elkhayder/PFE-DUT-2022-SmartCane/rapport/titlepage.tex

\makeatletter
\begin{titlepage}
\begin{center}
    
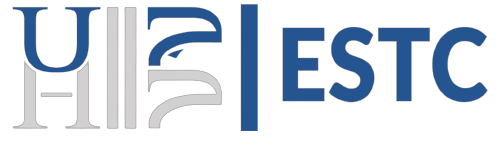
[picture p1: rapport/assets/estc.png]


\textbf{\large{
    Université HASSAN II de Casablanca \\
    École Supérieure de technologie \\
    Département Génie Électrique
}}
\\[4cm]

\textbf{\large{Rapport de projet de fin d'études}} \\[14pt]
Filière: Génie Électrique \\
Option: Électronique et informatique industrielle
\\[2cm]

\Small{Intitulé} \\
\textbf{\large{
Réalisation d'une canne intelligente avec sa propre\\
application mobile pour la navigation des malvoyants
}}

\vfill

\textbf{Realisé par :}
\hfill
\textbf{Encadré par :} \\
EL KHAYDER Zakaria
\hfill
Mme. DKHICHI Fairouz \\
\vspace{-4pt}
\begin{flushleft}
OUCHATO Iliass
\end{flushleft}
\\[1cm]

Année Universitaire \\
2021-2022
\\[24pt]

\end{center}
\end{titlepage}
\makeatother
