elkhayder/PFE-DUT-2022-SmartCane/rapport/code/app/send_current_location_sms.tex

\begin{code}
\begin{minted}[frame=single,
               framesep=3mm,
               linenos=true,
               xleftmargin=21pt,
               tabsize=4, fontsize=\small, breaklines]{dart}
class SendCurrentLocationSMS implements BluetoothPayloadHandler {
  final Telephony telephony = Telephony.instance;
  final LocationService location = LocationService();

  @override
  String command = "SEND_LOCATION_SMS";

  @override
  void handle(List<String> args) async {
    var currentLocation = await location.updateCurrentLocation();
    var prefs = await SharedPreferences.getInstance();
    String message = prefs.getString("emergencyMessage") ?? Constants.defaultEmergencyMessage;
    List<EmergencyContact> contacts = await Helpers.fetchEmergencyContacts();

    if (currentLocation?.longitude != null && currentLocation?.latitude != null) {
      message += "https://www.google.com/maps/search/?api=1&query=${currentLocation
      !.latitude!.toString()}%2C${currentLocation.longitude!.toString()}";
    }

    if (contacts.isEmpty) {
      await Helpers.speak(
        "You don't have any emergency contacts, please add at least one in the settings menu.",
      );
      return;
    }

    for (var c in contacts) {
      await telephony.sendSms(
        to: c.phone,
        message: message,
      );
    }

    await Helpers.speak(
      "Location SMS sent to ${contacts.length} ${contacts.length == 1 ? "person" : "people"}",
    );
  }
}
\end{minted}
\caption{Expéditeur d'SMS d'urgence}
\end{code}
