elkhayder/PFE-DUT-2022-SmartCane/rapport/code/arduino/Button.tex

\begin{code}
\begin{minted}[frame=single, framesep=3mm, linenos=true, xleftmargin=21pt, tabsize=4, fontsize=\small, breaklines]{cpp}

#include <Arduino.h>

#include "../../includes/ringtones.cpp"

class Button {
public:
    // All times are in ms
    unsigned long singlePressPolling = 1000;
    unsigned long doublePressTimeout = 250;
    unsigned long longPressTriggerTimeout = 1000;
    unsigned long minPressPolling = 10;

private:
    int _port;
    bool _prevState = false;
    bool _currentState = false;
    bool _singlePressInQueue = false;
    bool _longPressInProgress = false;
    unsigned long _lastPressedAt = 0;

    // Handlers
    void (*_onPress)();
    void (*_onDoublePress)();
    void (*_onLongPress)();

    static void _defaultHandler() {}

public:
    Button(
        int port,
        void (*onPress)(),
        void (*onDoublePress)() = _defaultHandler,
        void (*onLongPress)() = _defaultHandler
    ) {
        _port = port;
        _onPress = onPress;
        _onDoublePress = onDoublePress;
        _onLongPress = onLongPress;

        pinMode(port, INPUT_PULLUP);
    }

    void listen() {
        _currentState = !(bool)digitalRead(_port);

        if (millis() < _lastPressedAt + minPressPolling)
            return;

        if (_singlePressInQueue) {
            if (_currentState && _prevState) {
                if (millis() >= _lastPressedAt + longPressTriggerTimeout) {
                    handleLongPress();
                    _singlePressInQueue = false;
                    _longPressInProgress = false;
                    _lastPressedAt = millis();
                }
            } else if (millis() <= _lastPressedAt + doublePressTimeout && _currentState && !_prevState) {
                handleDoublePress();
                _singlePressInQueue = false;
                _lastPressedAt = millis();
            } else if (millis() > _lastPressedAt + doublePressTimeout) {
                handlePress();
                _singlePressInQueue = false;
                _lastPressedAt = millis();
            }
        } else if (millis() >= _lastPressedAt + singlePressPolling && _currentState && !_prevState) {
            _singlePressInQueue = true;
            _longPressInProgress = false;
            _lastPressedAt = millis();
        }

        _prevState = _currentState;
    }

private:
    void handlePress() {
        Ringtones::buttonClick.play();
        _onPress();
    }

    void handleDoublePress() {
        Ringtones::buttonDoubleClick.play();
        _onDoublePress();
    }

    void handleLongPress() {
        Ringtones::buttonLongClick.play();
        _onLongPress();
    }
};
\end{minted}
\caption{Button}
\end{code}
