elkhayder/PFE-DUT-2022-SmartCane/rapport/dedicace.tex

\chapter*{Dédicace}
\addcontentsline{toc}{chapter}{Dédicace}

Nous dédions ce modeste travail à : \\
\begin{itemize}
    \item En premier lieu ceux que personne ne peut compenser les sacrifices qu’ils ont consentis pour notre éducation et notre bien-être à nos parents qui se sont sacrifiés pour nous prendre en charge tout au long de notre formation et qui sont l’origine de notre réussite que dieu les garde et les protèges.
    \item A notre famille et nos chers amis qui nous ont accordé leur soutien dans les instants les plus difficiles.
    \item Tous nos formateurs et toute l’équipe pédagogique et administrative de \acrshort{estc} pour l’aide qu’ils ont toujours porté aux étudiants.
    \item Toute personne qui de près ou de loin a participé à notre formation.
\end{itemize}
