elkhayder/PFE-DUT-2022-SmartCane/rapport/remerciement.tex

\chapter*{Remerciement}
\addcontentsline{toc}{chapter}{Remerciement}

Au terme de ce travail, on tient à exprimer notre profonde gratitude à notre chère professeur et encadrante \textbf{Mme.\ DKHICHI Fairouz} pour son suivi et pour son énorme soutien %, qu’elle n’a cessé de nous prodiguer 
tout au long de la période du projet. \\
On tient à remercier également \textbf{M. LAROUI Abderrahim} et \textbf{M. BOUTAKAOUA BACHIR\\Mohamed} pour le temps qu’ils ont consacré et pour les précieuses informations lors de la conception et la réalisation de notre projet. \\
On adresse aussi nos vifs remerciements aux membres des jurys pour avoir bien voulu examiner et juger ce travail. \\
On ne laissera pas cette occasion passer, sans remercier tous les enseignants et le personnel de \textbf{\acrfull{estc}}, et particulièrement ceux du département électrique pour leur aide et leurs précieux conseils et pour l’intérêt qu’ils portent à notre formation. \\
Enfin, nos remerciements à tous ceux qui ont contribué de prés ou de loin au bon déroulement de ce projet de fin d'étude.
%Tous nos camarades de promotion pour la solidarité et la collaboration durant ces trois ans de formation.
