elkhayder/PFE-DUT-2022-SmartCane/rapport/assets/conception1/21.png

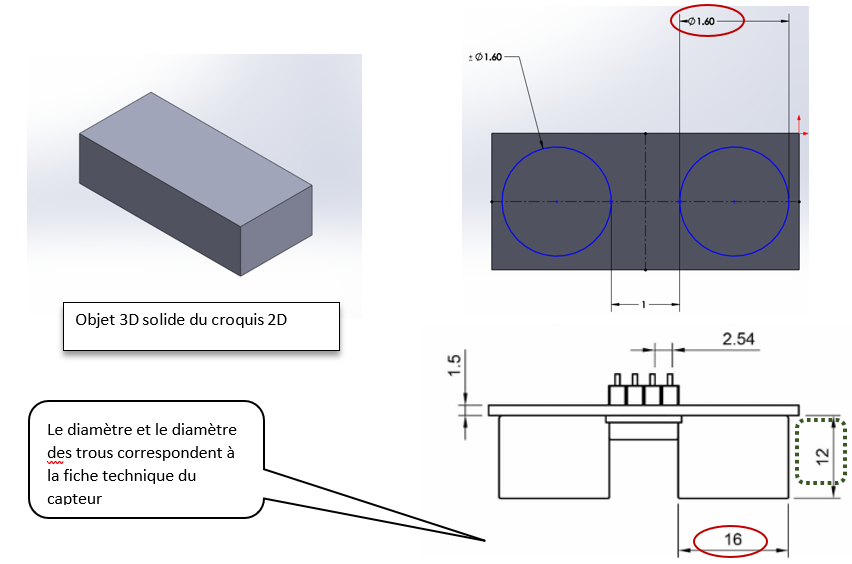
rapport/assets/conception1/21.png
