elkhayder/PFE-DUT-2022-SmartCane/rapport/assets/conception1/img38.jpg

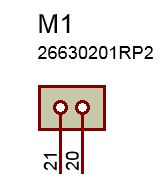
rapport/assets/conception1/img38.jpg
