elkhayder/PFE-DUT-2022-SmartCane/rapport/assets/conception1/img148.jpg

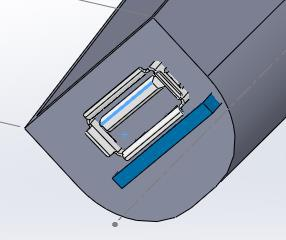
rapport/assets/conception1/img148.jpg
