elkhayder/PFE-DUT-2022-SmartCane/rapport/assets/conception1/img245.jpg

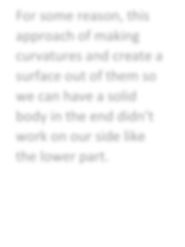
rapport/assets/conception1/img245.jpg
