elkhayder/PFE-DUT-2022-SmartCane/rapport/assets/conception1/img249.jpg

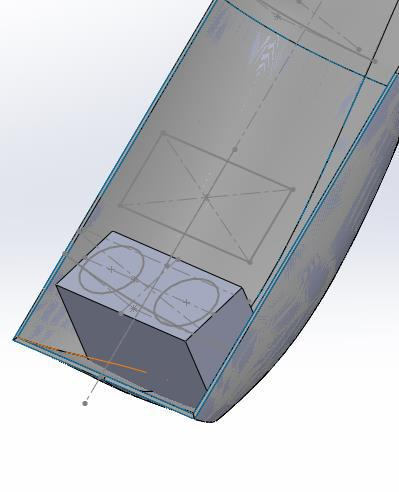
rapport/assets/conception1/img249.jpg
