elkhayder/PFE-DUT-2022-SmartCane/rapport/assets/conception1/img298.jpg

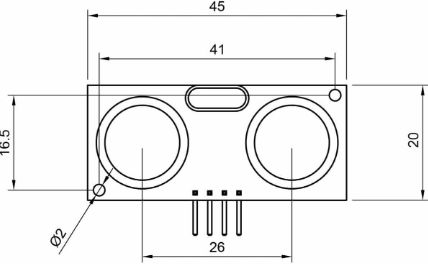
rapport/assets/conception1/img298.jpg
