elkhayder/PFE-DUT-2022-SmartCane/rapport/assets/conception1/injection-moulding-process-stage1-356x141.gif

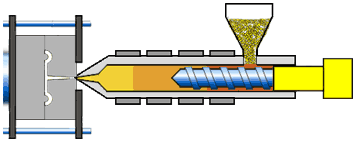
rapport/assets/conception1/injection-moulding-process-stage1-356x141.gif
