elkhayder/PFE-DUT-2022-SmartCane/rapport/assets/HC-05/circuit.png

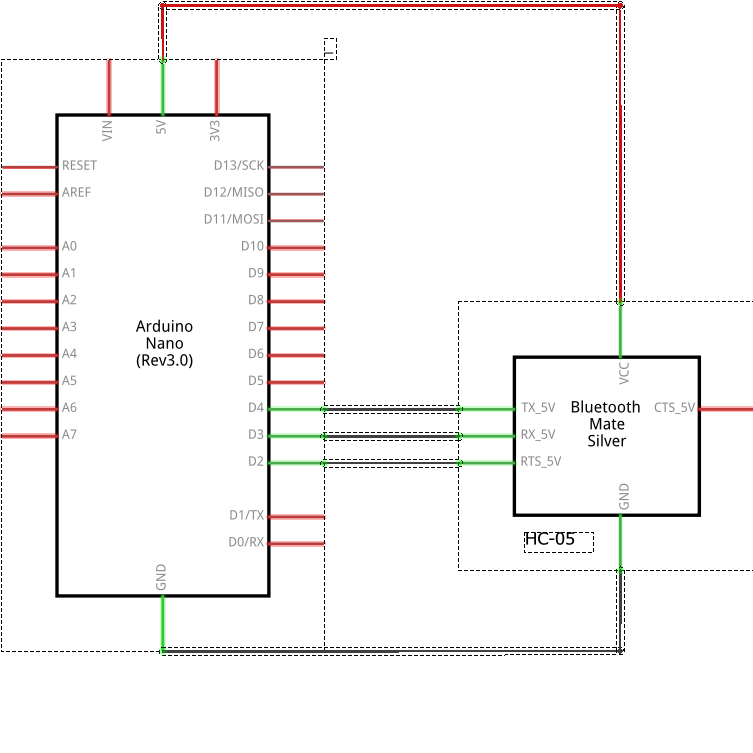
rapport/assets/HC-05/circuit.png
