elkhayder/PFE-DUT-2022-SmartCane/rapport/assets/HC-SR04/pinout.png

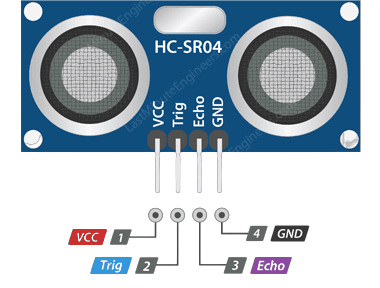
rapport/assets/HC-SR04/pinout.png
