elkhayder/PFE-DUT-2022-SmartCane/rapport/assets/L293D/pinout.png

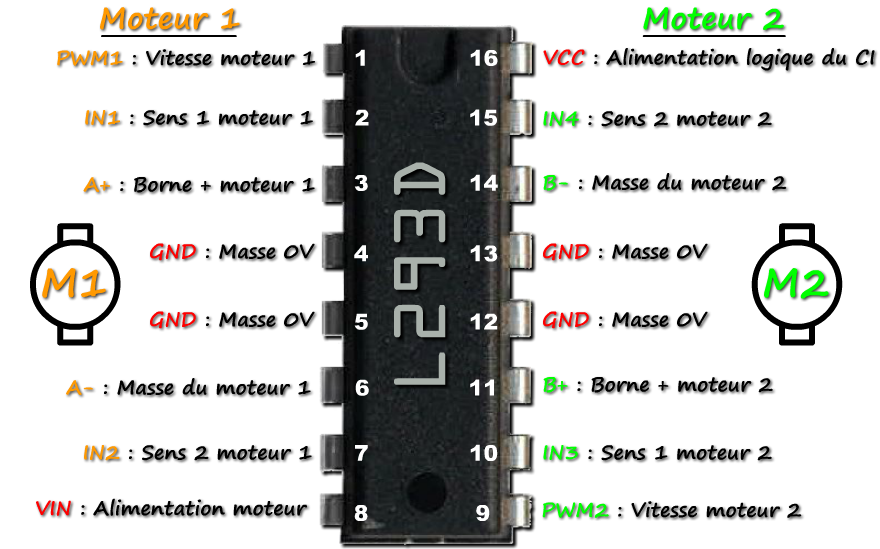
rapport/assets/L293D/pinout.png
