elkhayder/PFE-DUT-2022-SmartCane/rapport/assets/realisation/1.jpg

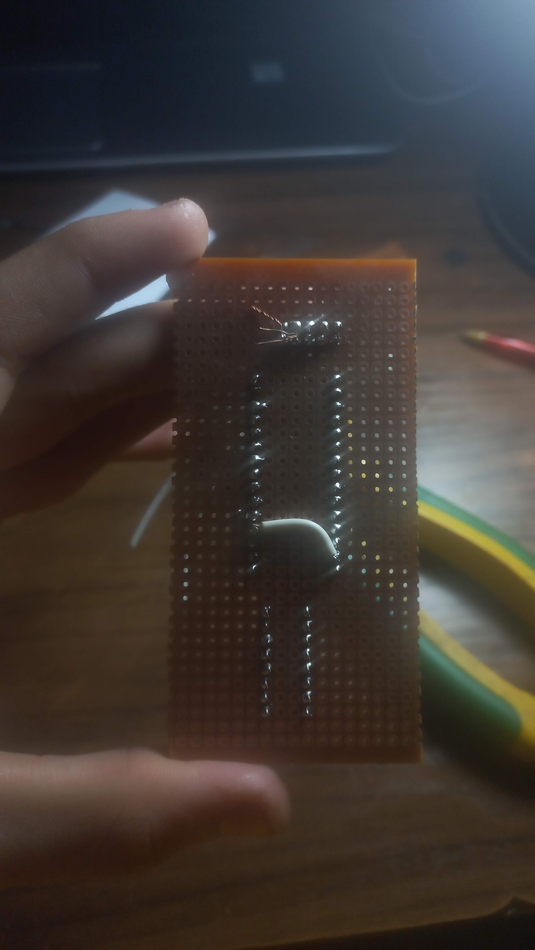
rapport/assets/realisation/1.jpg
