elkhayder/PFE-DUT-2022-SmartCane/rapport/assets/realisation/2.jpg

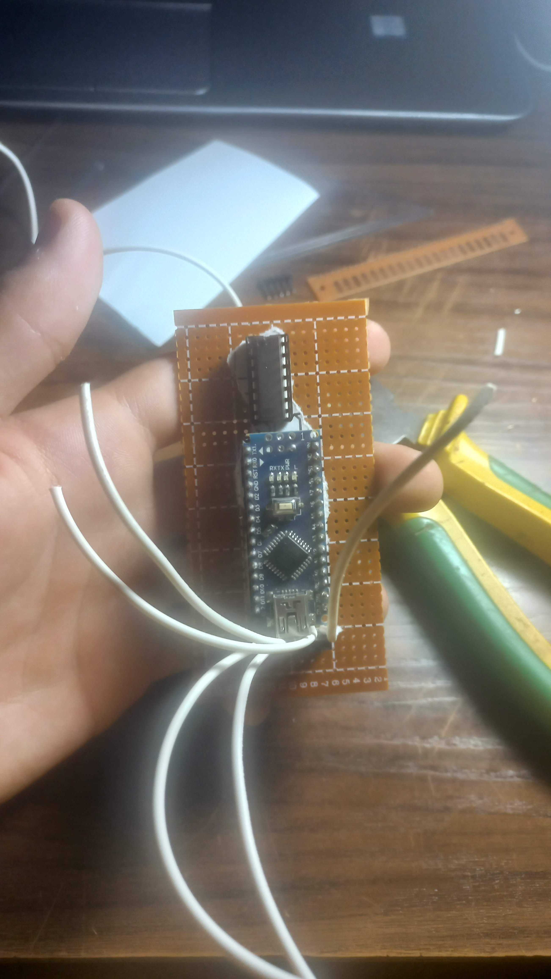
rapport/assets/realisation/2.jpg
