elkhayder/PFE-DUT-2022-SmartCane/rapport/assets/realisation/3.jpg

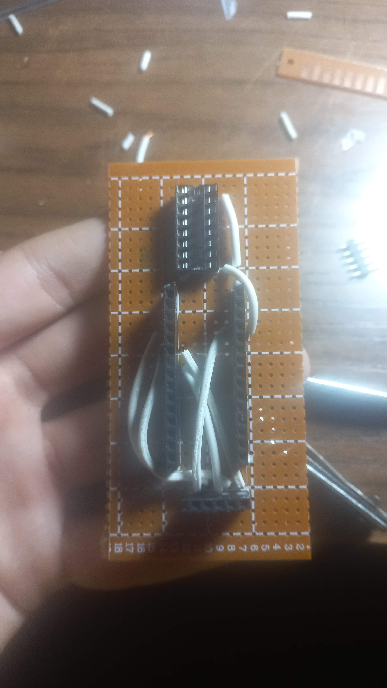
rapport/assets/realisation/3.jpg
