elkhayder/PFE-DUT-2022-SmartCane/rapport/assets/realisation/20220409_154331.jpg

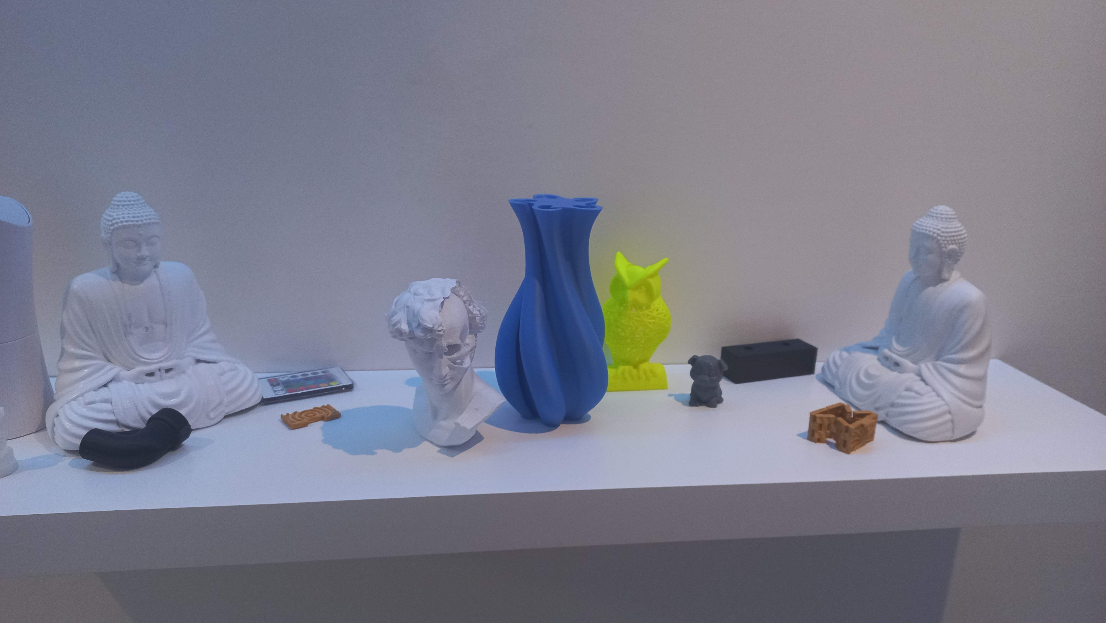
rapport/assets/realisation/20220409_154331.jpg
