elkhayder/PFE-DUT-2022-SmartCane/rapport/assets/realisation/20220409_162800.jpg

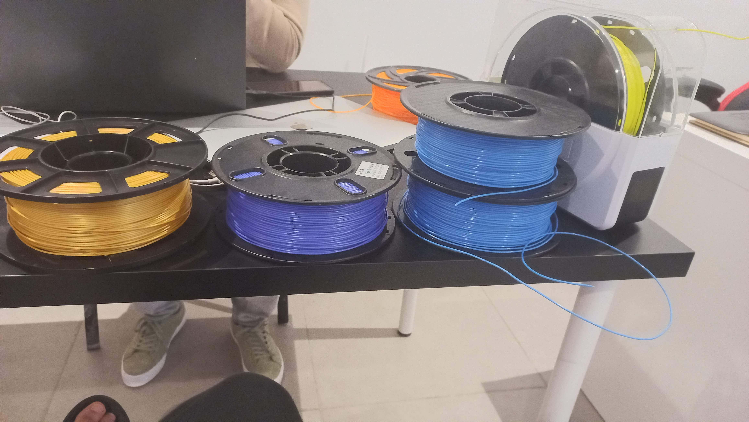
rapport/assets/realisation/20220409_162800.jpg
