elkhayder/PFE-DUT-2022-SmartCane/rapport/assets/realisation/cartes/2022-03-25 11.55.35.jpeg

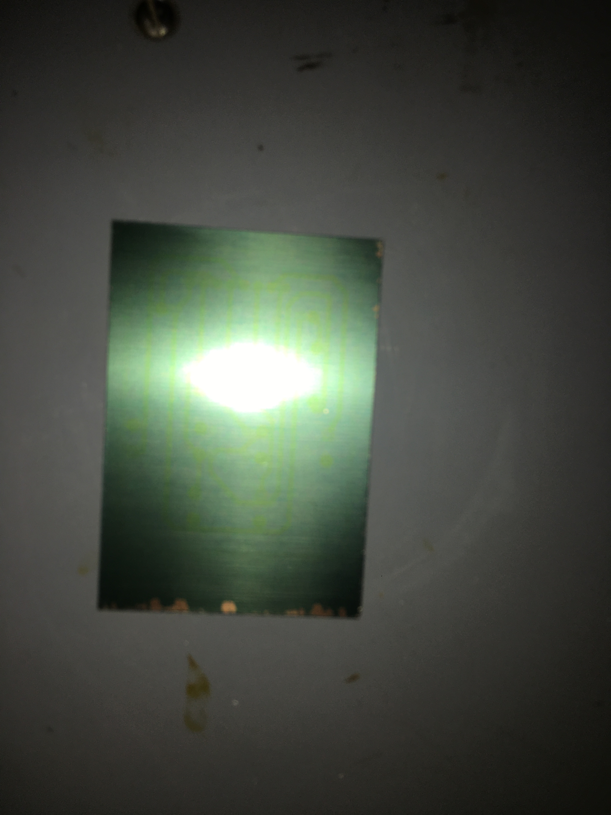
rapport/assets/realisation/cartes/2022-03-25 11.55.35.jpeg
