elkhayder/PFE-DUT-2022-SmartCane/rapport/assets/realisation/cartes/2022-03-25 12.16.34.jpeg

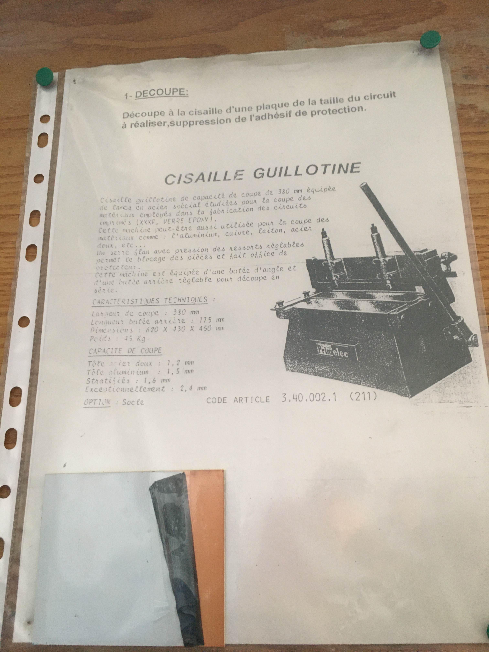
rapport/assets/realisation/cartes/2022-03-25 12.16.34.jpeg
