elkhayder/PFE-DUT-2022-SmartCane/rapport/assets/realisation/cartes/2022-03-25 16.49.51.jpeg

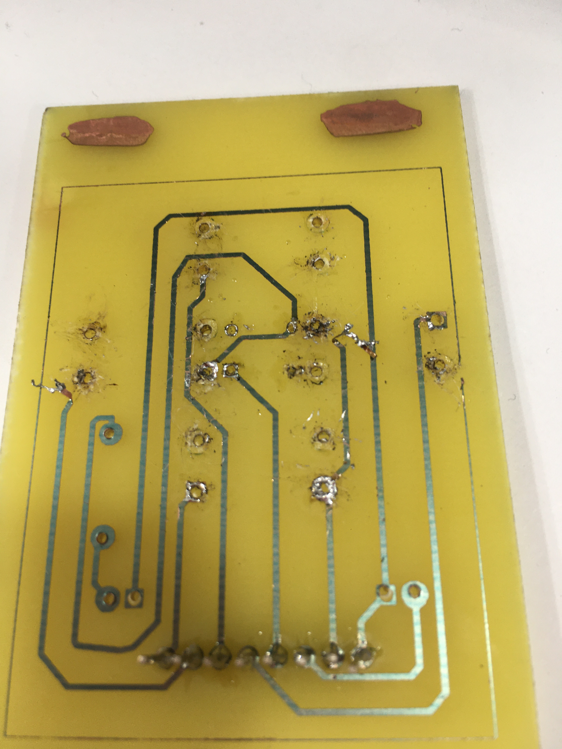
rapport/assets/realisation/cartes/2022-03-25 16.49.51.jpeg
