elkhayder/PFE-DUT-2022-SmartCane/rapport/assets/realisation/cartes/2022-03-25 18.37.08.jpeg

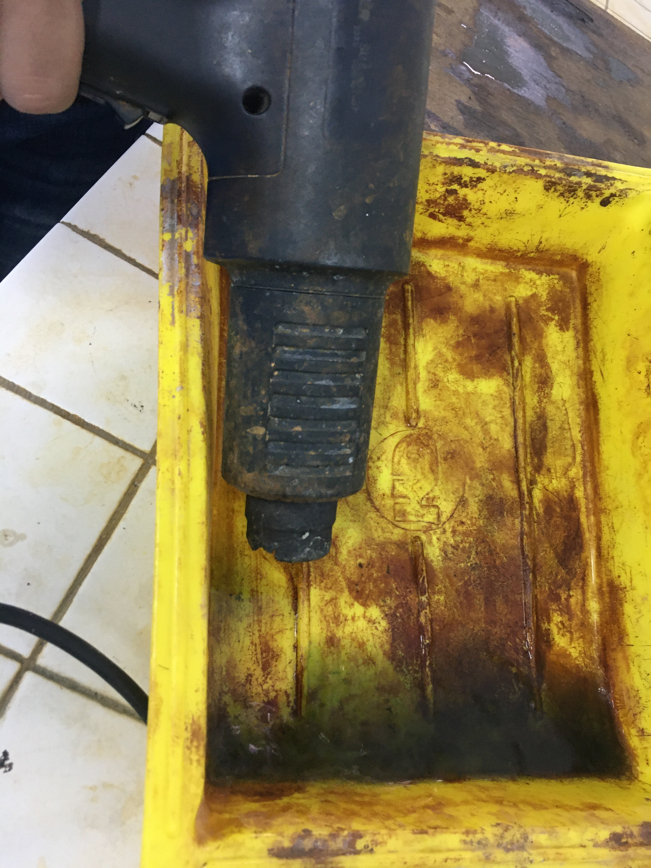
rapport/assets/realisation/cartes/2022-03-25 18.37.08.jpeg
