elkhayder/PFE-DUT-2022-SmartCane/rapport/assets/realisation/cartes/2022-03-28 17.06.08.jpeg

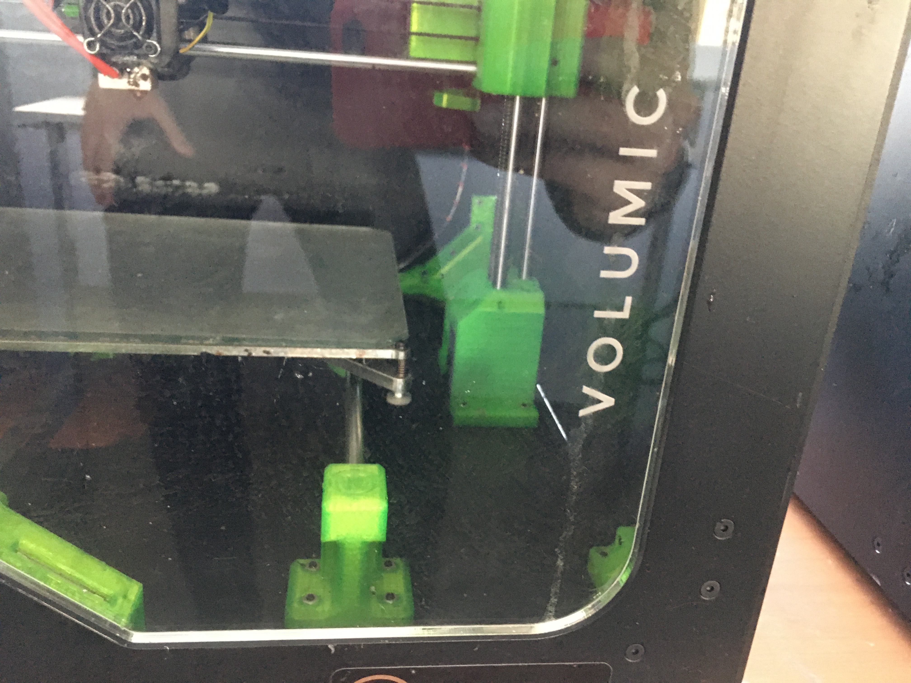
rapport/assets/realisation/cartes/2022-03-28 17.06.08.jpeg
