elkhayder/PFE-DUT-2022-SmartCane/rapport/assets/realisation/cartes/2022-03-28 22.32.55.jpeg

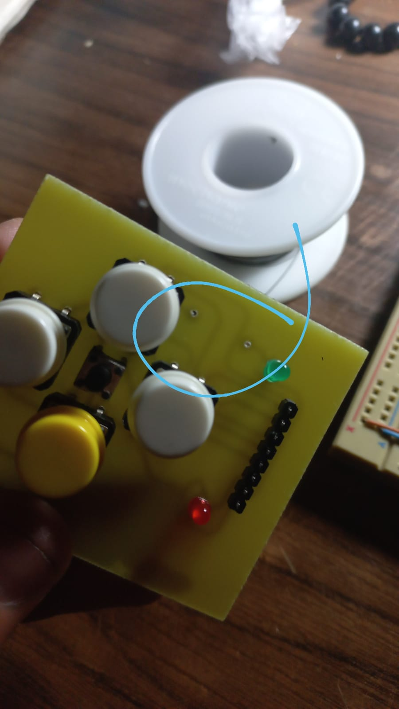
rapport/assets/realisation/cartes/2022-03-28 22.32.55.jpeg
