elkhayder/PFE-DUT-2022-SmartCane/rapport/assets/realisation/cartes/2022-03-29 15.10.32.jpeg

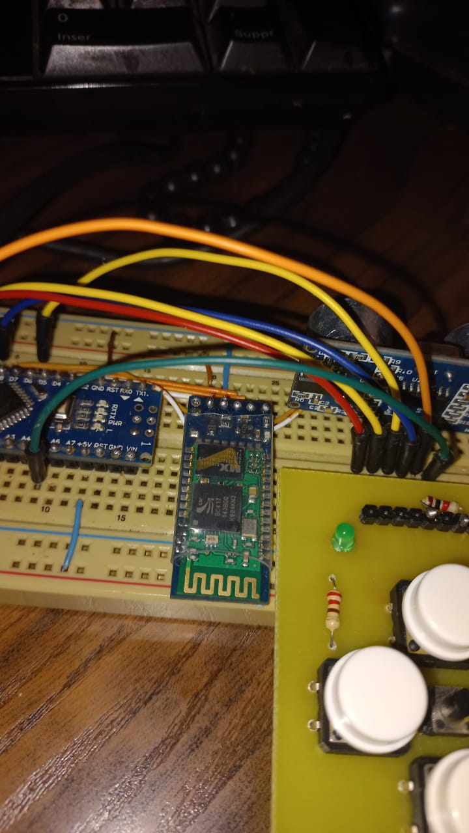
rapport/assets/realisation/cartes/2022-03-29 15.10.32.jpeg
