elkhayder/PFE-DUT-2022-SmartCane/rapport/assets/realisation/cartes/2022-03-30 11.13.27.jpeg

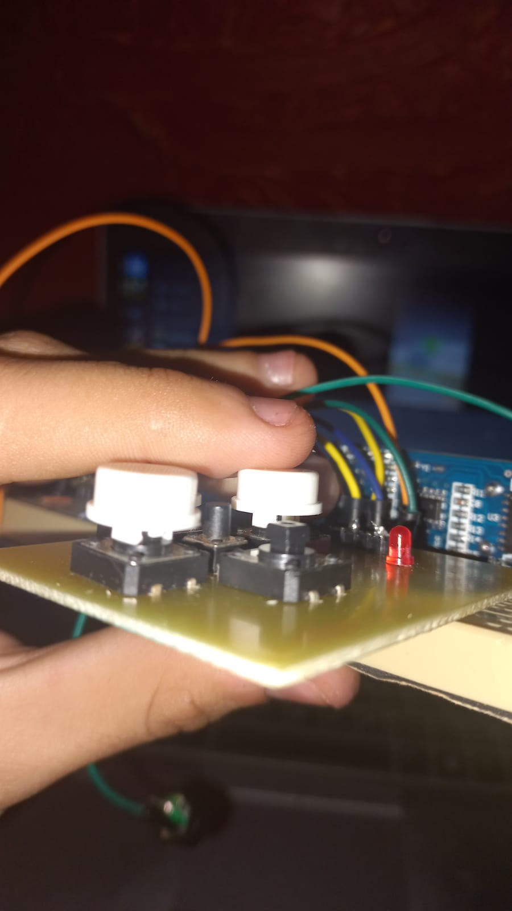
rapport/assets/realisation/cartes/2022-03-30 11.13.27.jpeg
