elkhayder/PFE-DUT-2022-SmartCane/rapport/assets/realisation/cartes/2022-04-05 12.51.25.jpeg

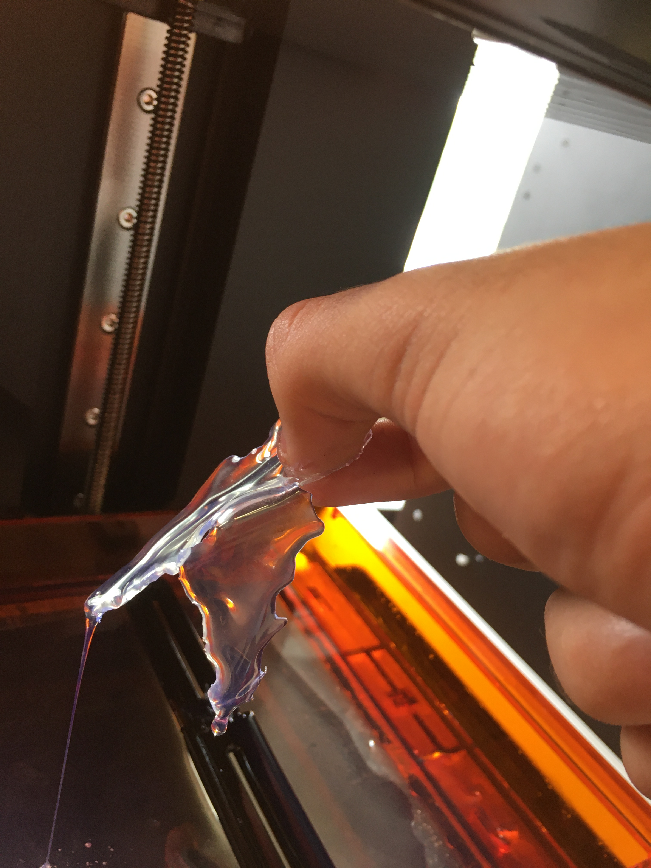
rapport/assets/realisation/cartes/2022-04-05 12.51.25.jpeg
