elkhayder/PFE-DUT-2022-SmartCane/rapport/assets/realisation/cartes/2022-04-05 16.03.58.jpeg

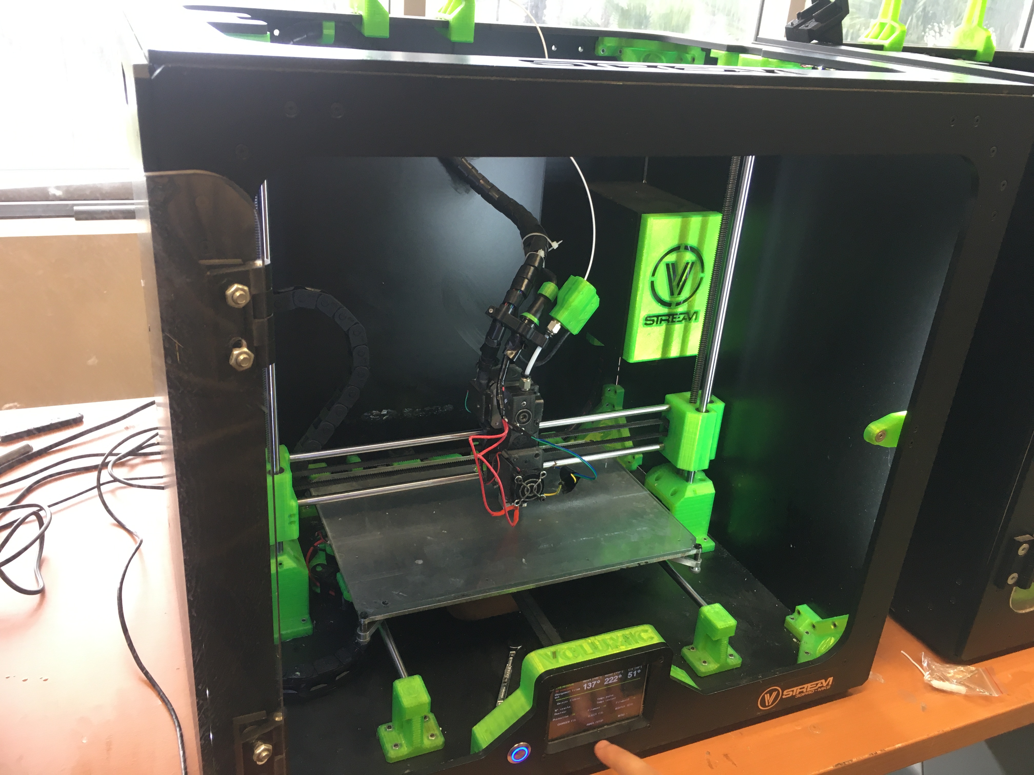
rapport/assets/realisation/cartes/2022-04-05 16.03.58.jpeg
