elkhayder/PFE-DUT-2022-SmartCane/rapport/assets/realisation/dpsd/2.jpg

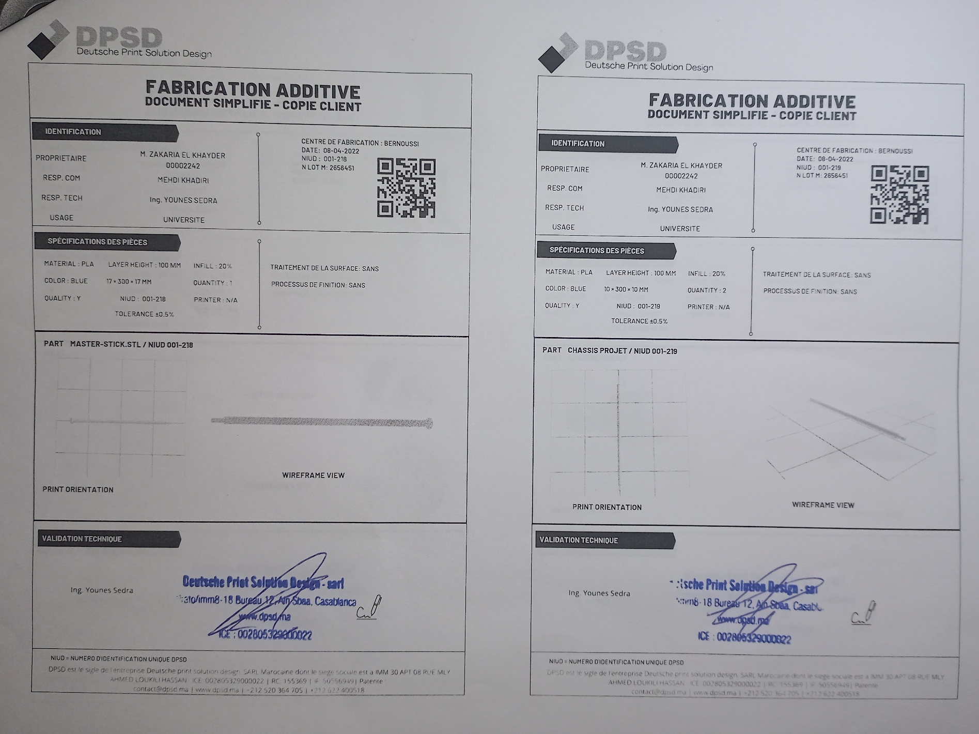
rapport/assets/realisation/dpsd/2.jpg
