elkhayder/PFE-DUT-2022-SmartCane/rapport/assets/realisation/dpsd/3.jpg

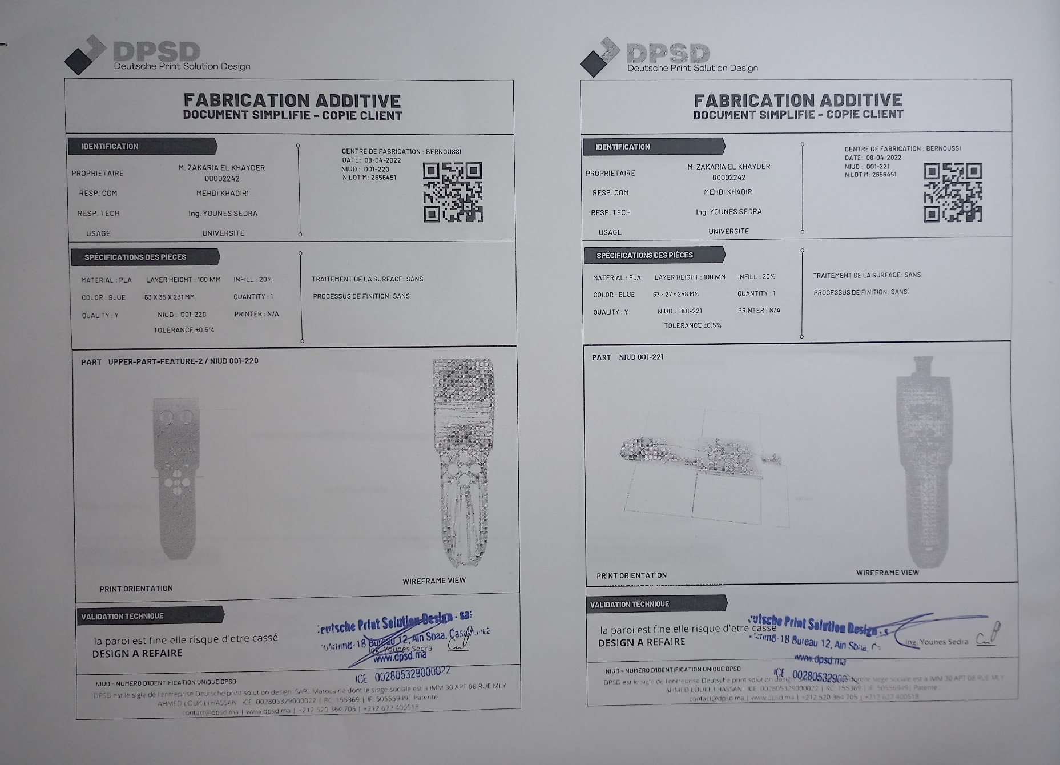
rapport/assets/realisation/dpsd/3.jpg
