elkhayder/PFE-DUT-2022-SmartCane/rapport/assets/realisation/x5.jpeg

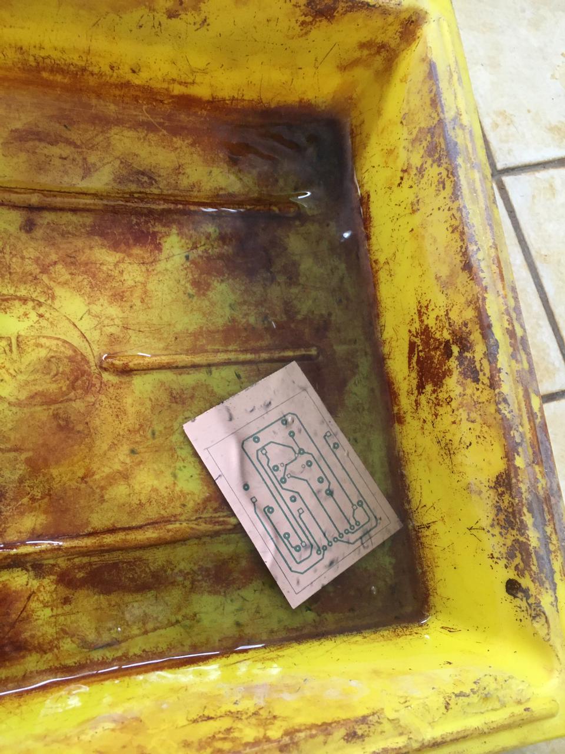
rapport/assets/realisation/x5.jpeg
