elkhayder/PFE-DUT-2022-SmartCane/rapport/assets/realisation/x6.jpeg

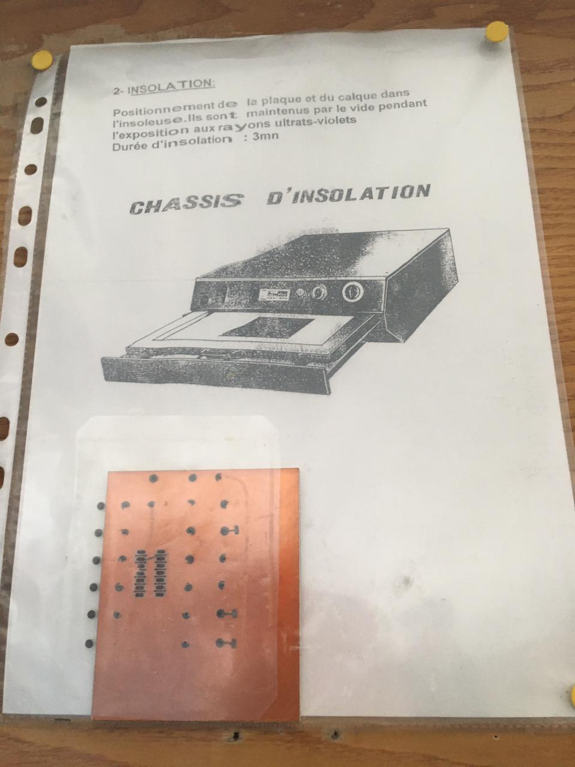
rapport/assets/realisation/x6.jpeg
