elkhayder/PFE-DUT-2022-SmartCane/rapport/assets/realisation/x8.jpeg

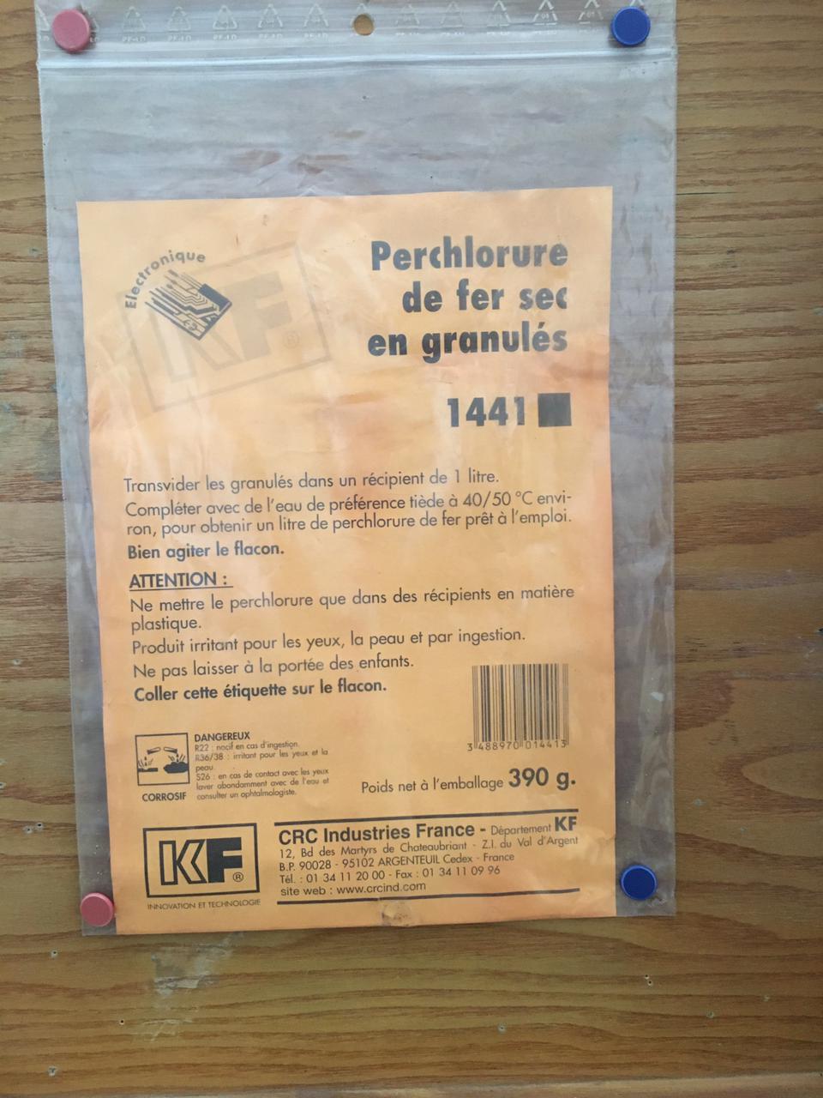
rapport/assets/realisation/x8.jpeg
