elkhayder/PFE-DUT-2022-SmartCane/rapport/assets/realisation/x9.jpeg

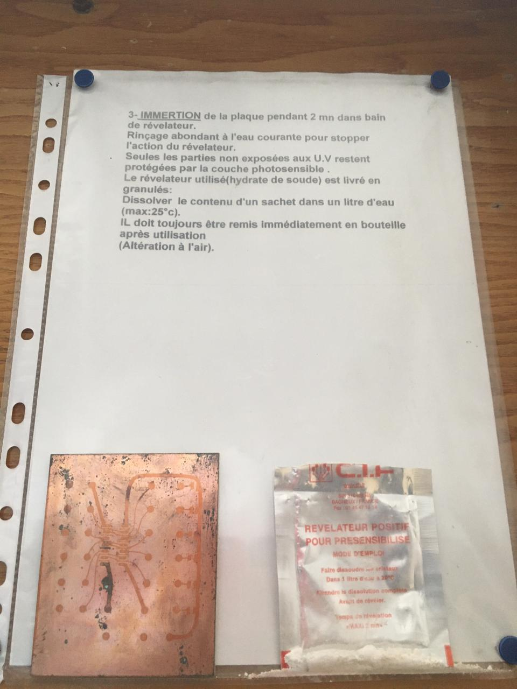
rapport/assets/realisation/x9.jpeg
