elkhayder/PFE-DUT-2022-SmartCane/rapport/assets/realisation/x10.jpeg

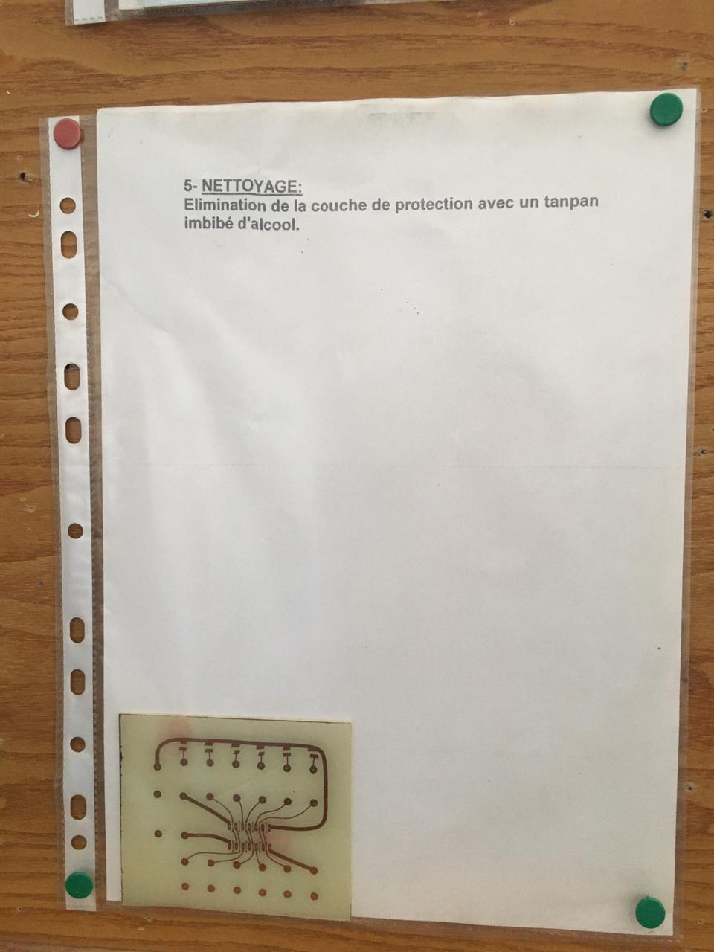
rapport/assets/realisation/x10.jpeg
