elkhayder/PFE-DUT-2022-SmartCane/rapport/assets/realisation/x11.jpeg

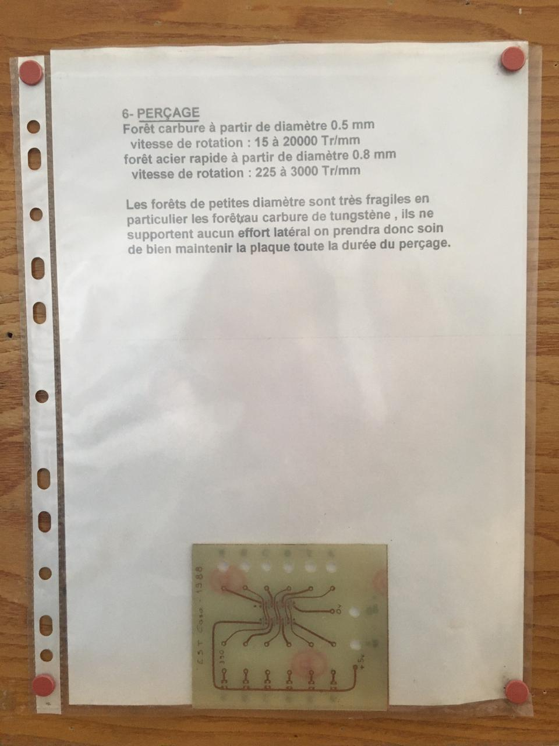
rapport/assets/realisation/x11.jpeg
