elkhayder/PFE-DUT-2022-SmartCane/rapport/assets/realisation/x13.jpeg

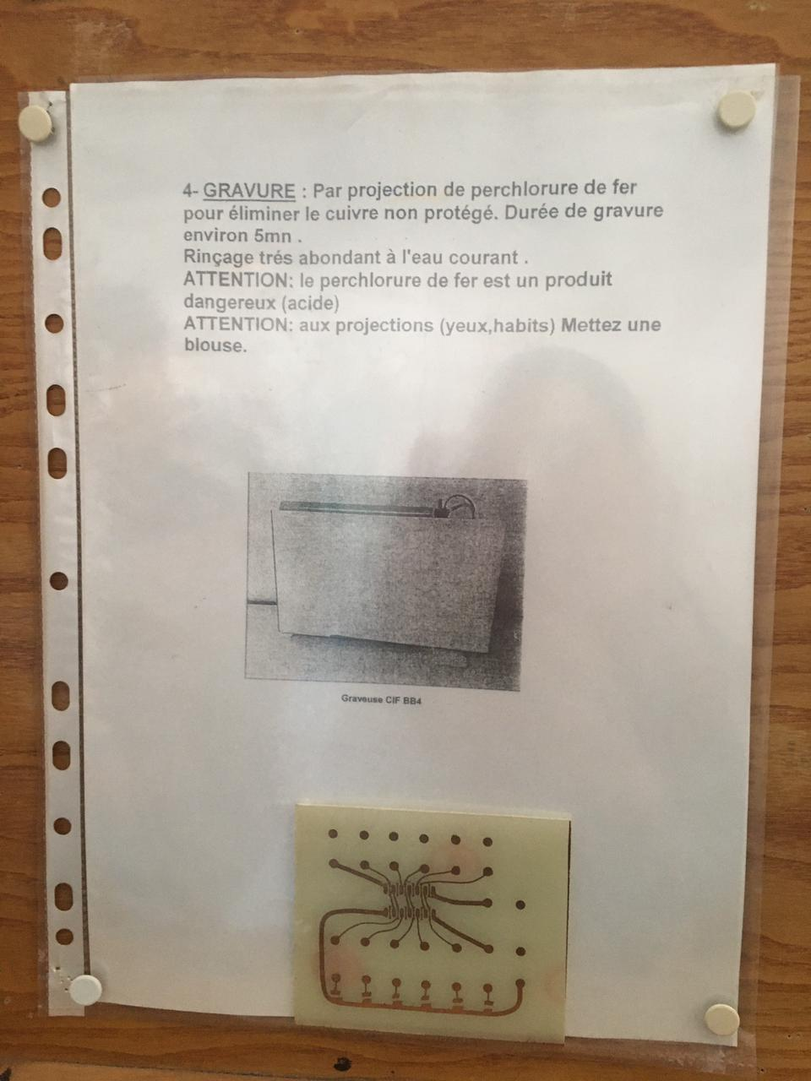
rapport/assets/realisation/x13.jpeg
