elkhayder/PFE-DUT-2022-SmartCane/rapport/assets/realisation/x15.jpeg

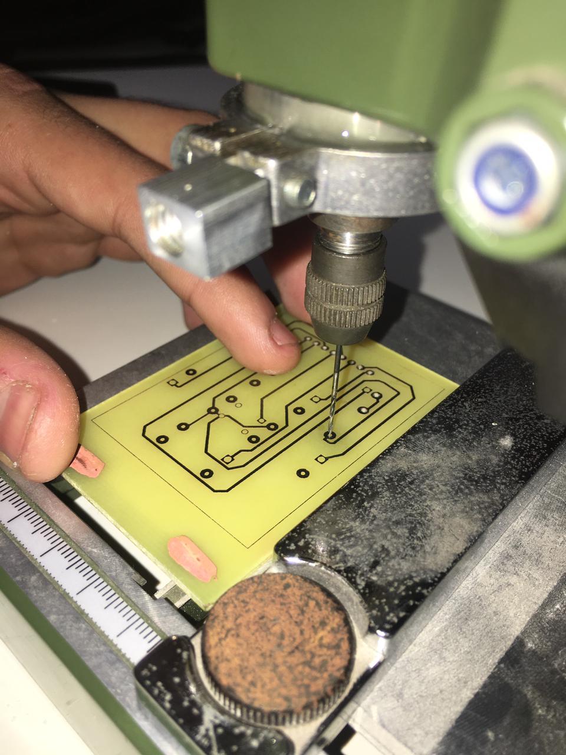
rapport/assets/realisation/x15.jpeg
