elkhayder/PFE-DUT-2022-SmartCane/rapport/assets/uh2c.png

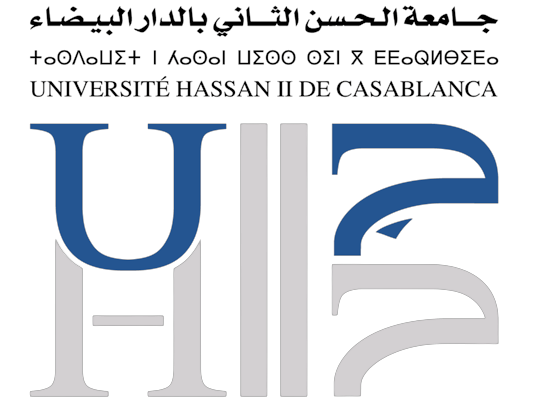
rapport/assets/uh2c.png
