elkhayder/PFE-DUT-2022-SmartCane/sw/guideme v3.SLDASM

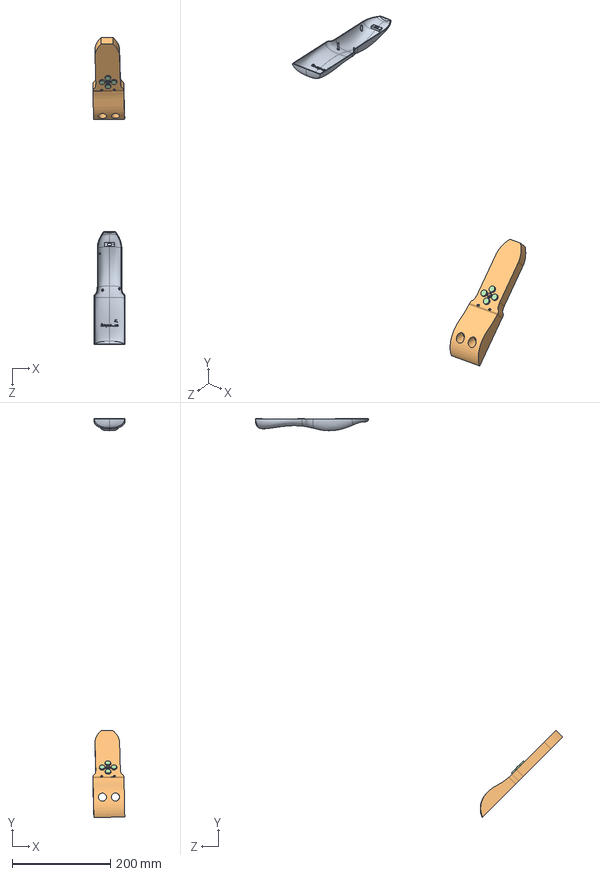
[picture p271: CAD file, 2022-04-11]
sw/guideme v3.SLDASM
65.9 x 812.3 x 625.9 mm
lower part v0.2
upper part feature
Buttons v2.2
button x 4
mid cap
