elkhayder/PFE-DUT-2022-SmartCane/sw/button pcb with caps.SLDASM

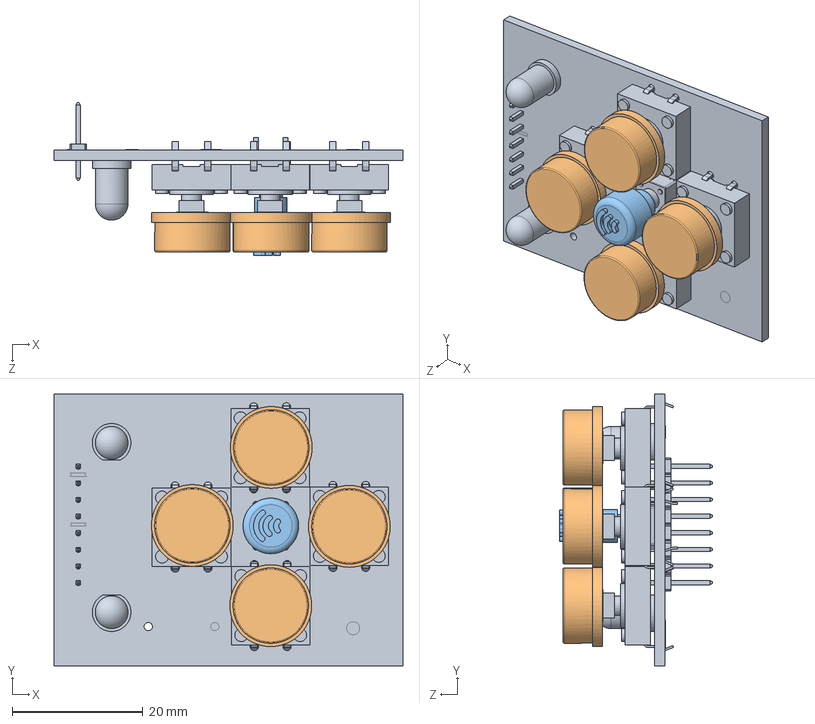
[picture p272: CAD file, 2022-04-11]
sw/button pcb with caps.SLDASM
53.3 x 41.5 x 23.4 mm
Buttons v2.2
button x 4
mid cap
