elkhayder/PFE-DUT-2022-SmartCane/sw/slide switch.SLDASM

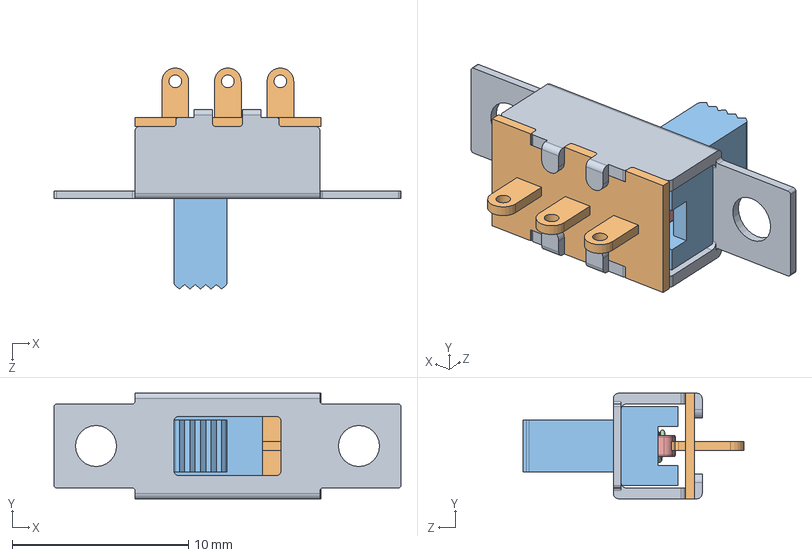
[picture p273: CAD file, 2022-04-11]
sw/slide switch.SLDASM
19.7 x 5.99 x 12.5 mm
корпус переключателя
контакти переключателя
ричаг переключателя
пружина переключателя
контакт переключателя
