elkhayder/PFE-DUT-2022-SmartCane/sw/upper part total.sldasm

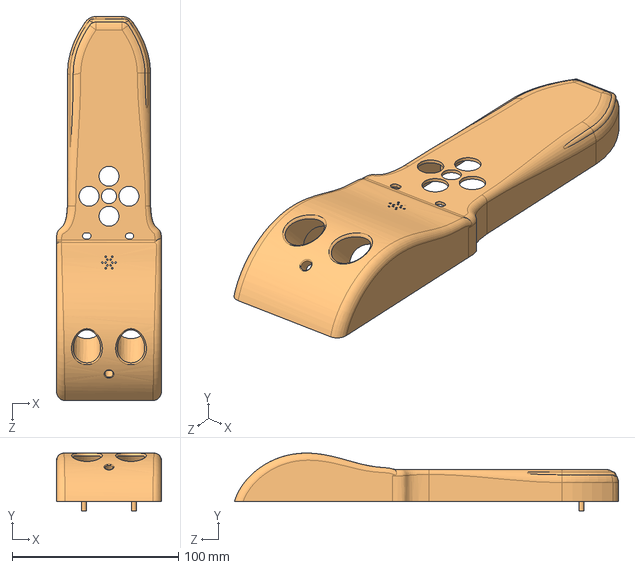
[picture p274: CAD file, 2022-04-11]
sw/upper part total.sldasm
63.1 x 34.7 x 230.7 mm
upper part
upper part 2
