elkhayder/PFE-DUT-2022-SmartCane/sw/upper part v2.SLDASM

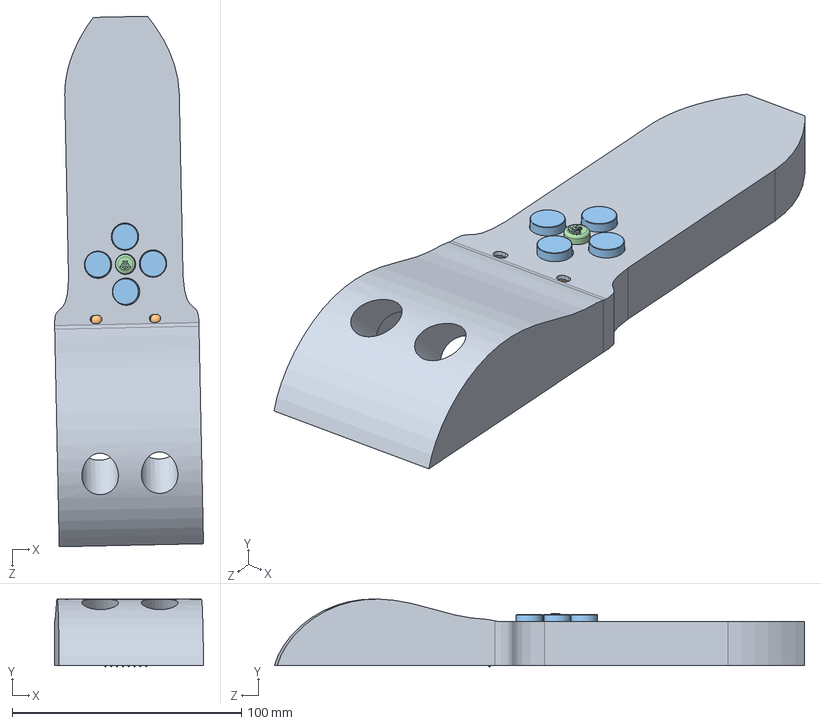
[picture p275: CAD file, 2022-04-11]
sw/upper part v2.SLDASM
65.0 x 29.6 x 231.6 mm
upper part feature
Buttons v2.2
button x 4
mid cap
