elkhayder/PFE-DUT-2022-SmartCane/sw/guideme v4 chassis.SLDASM

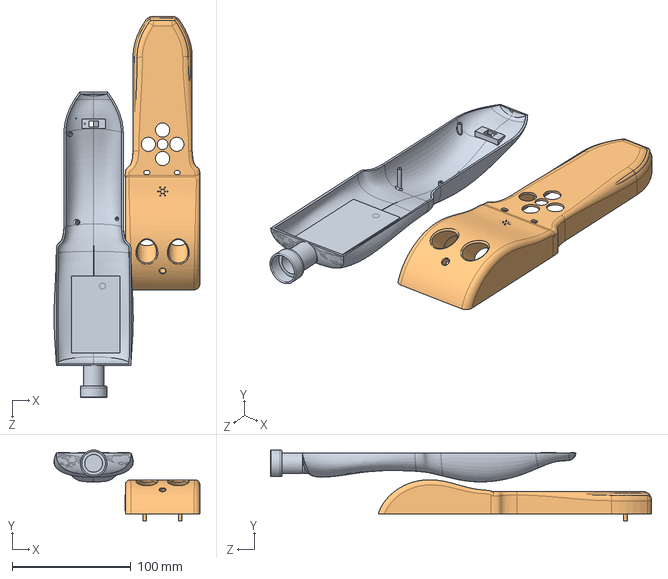
[picture p276: CAD file, 2022-04-11]
sw/guideme v4 chassis.SLDASM
123.1 x 59.9 x 321.8 mm
lower part v0.2
upper part feature
