elkhayder/PFE-DUT-2022-SmartCane/sw/Assem3.SLDASM

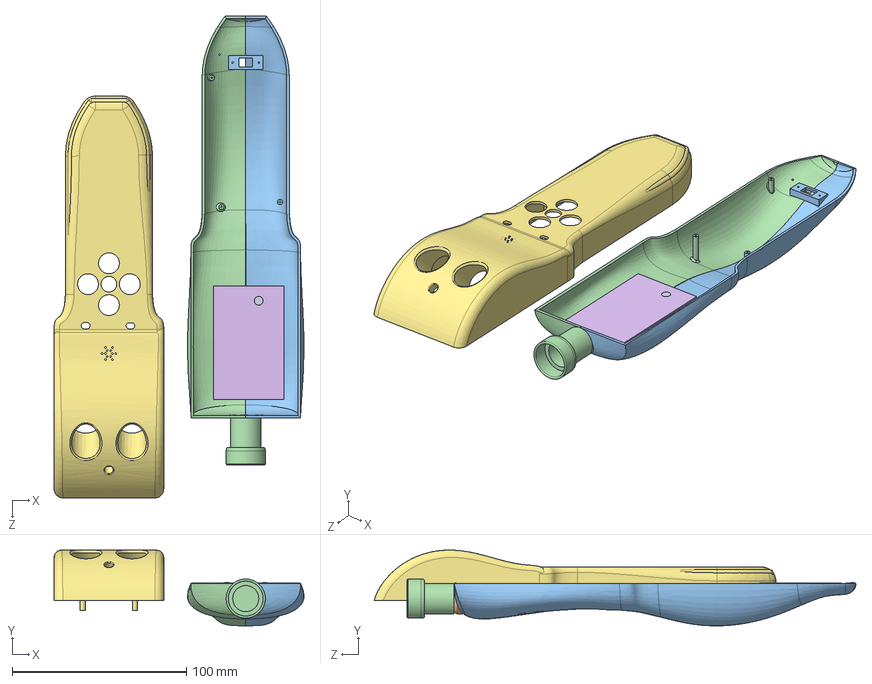
[picture p277: CAD file, 2022-04-11]
sw/Assem3.SLDASM
143.5 x 43.6 x 276.7 mm
upper part
upper part 2
