elkhayder/PFE-DUT-2022-SmartCane/sw/lower part.sldasm

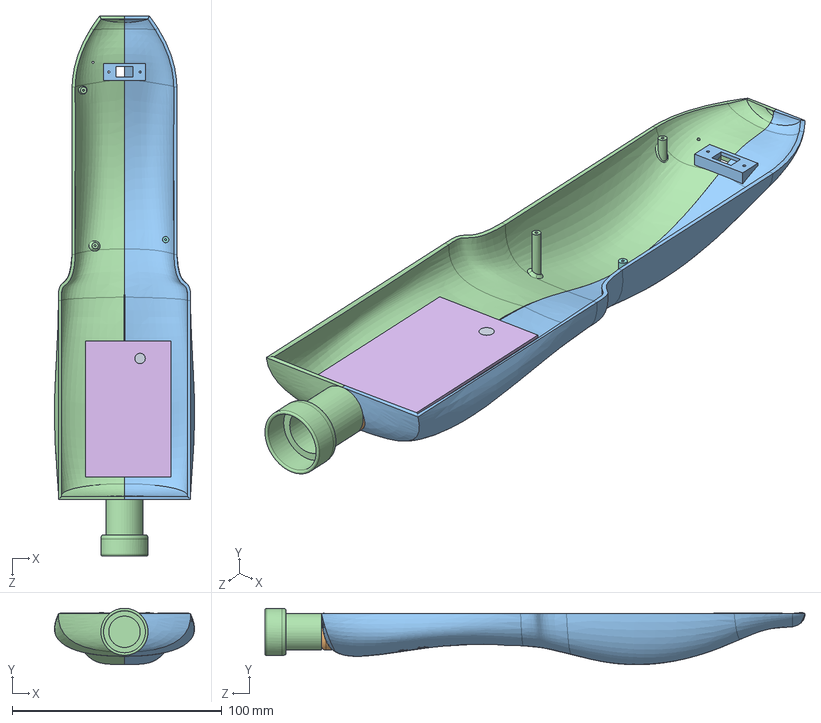
[picture p278: CAD file, 2022-04-11]
sw/lower part.sldasm
66.9 x 27.0 x 257.7 mm
