elkhayder/PFE-DUT-2022-SmartCane/sw/hc with socket.SLDASM

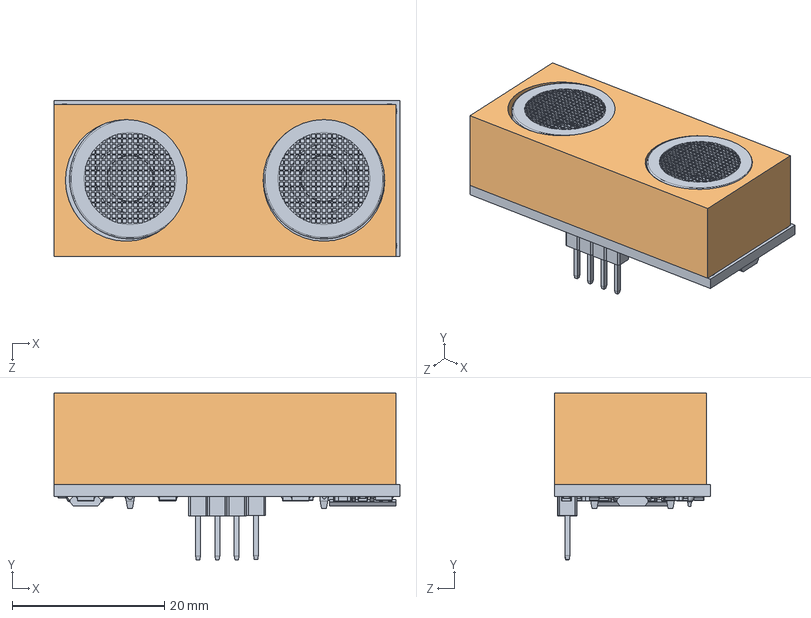
[picture p279: CAD file, 2022-04-05]
sw/hc with socket.SLDASM
45.5 x 22.0 x 20.5 mm
HC-SR04
sensor socket
