elkhayder/PFE-DUT-2022-SmartCane/sw/guidMe v1.SLDASM

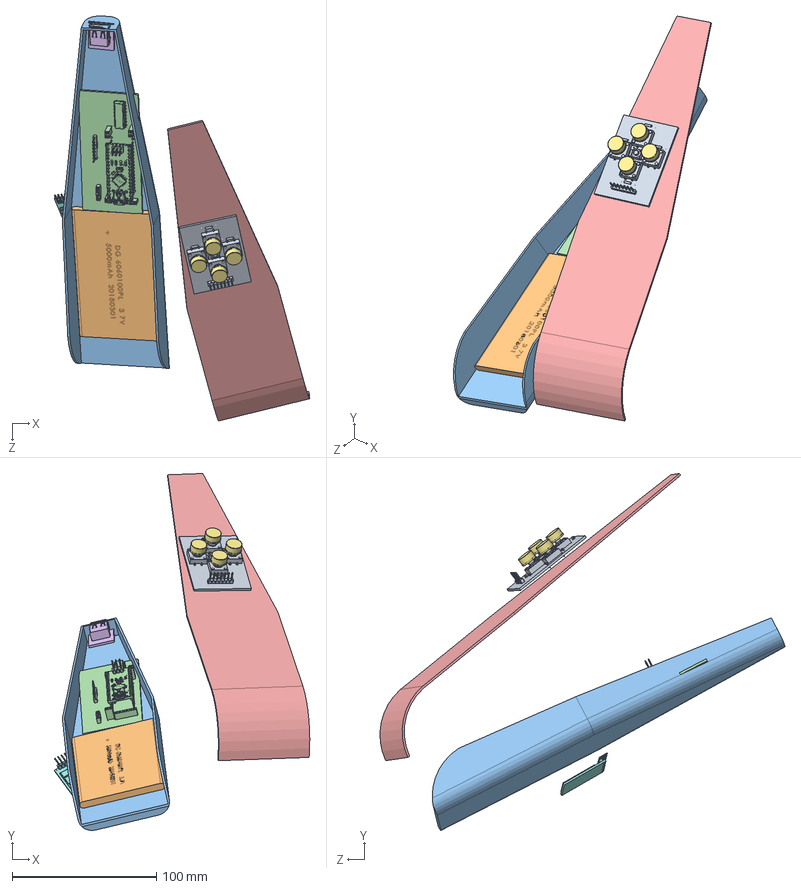
[picture p280: CAD file, 2022-03-25]
sw/guidMe v1.SLDASM
177.4 x 247.8 x 281.1 mm
button pcb
lipo
lower part v0.1
main pcb
upper part v0.1
usb board
button x 4
HC-05 Bluetooth
