elkhayder/PFE-DUT-2022-SmartCane/lower part v0.2.SLDPRT

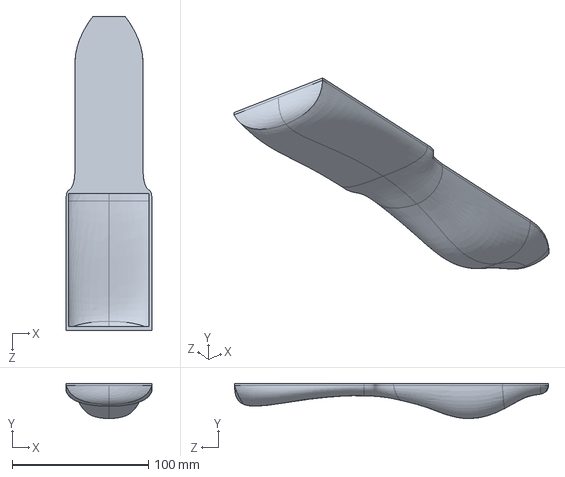
[picture p281: CAD file, 2022-04-02]
lower part v0.2.SLDPRT
63.5 x 25.9 x 230.7 mm
