elkhayder/PFE-DUT-2022-SmartCane/sw/proteus/button pcb.STEP

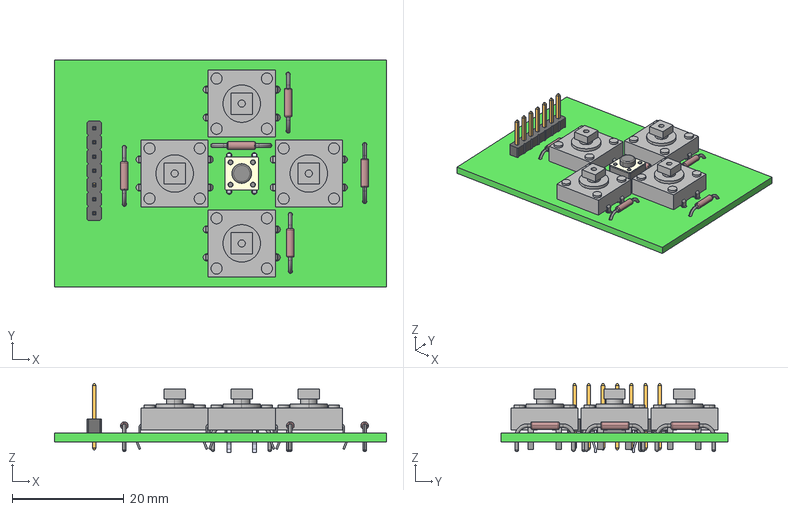
[picture p282: CAD file, 2022-04-20]
sw/proteus/button pcb.STEP
59.4 x 40.6 x 12.4 mm
Layer_1
Pin_1 x 5
Pin_2 x 5
=>[0:1:1:3]
=>[0:1:1:4]
=>[0:1:1:5]
=>[0:1:1:6]
=>[0:1:1:7]
=>[0:1:1:8]
=>[0:1:1:9]
=>[0:1:1:10]
=>[0:1:1:11]
=>[0:1:1:12]
=>[0:1:1:13]
7-Pin_Header_-_Male_-_2.54mm:1
