elkhayder/PFE-DUT-2022-SmartCane/sw/upper part feature -5.SLDPRT

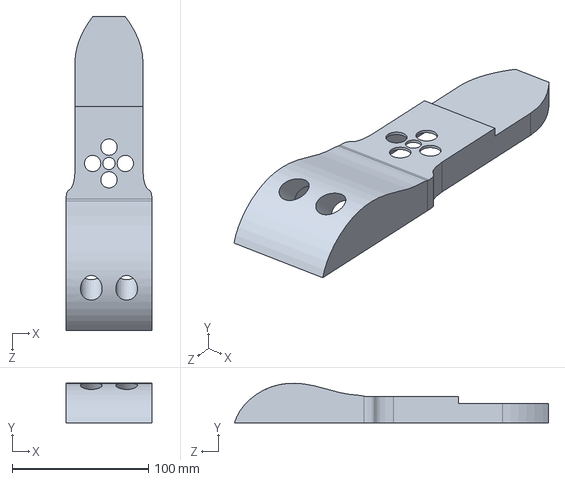
[picture p283: CAD file, 2022-04-11]
sw/upper part feature -5.SLDPRT
63.1 x 29.0 x 230.7 mm
