elkhayder/PFE-DUT-2022-SmartCane/sw/lower part v2.STL

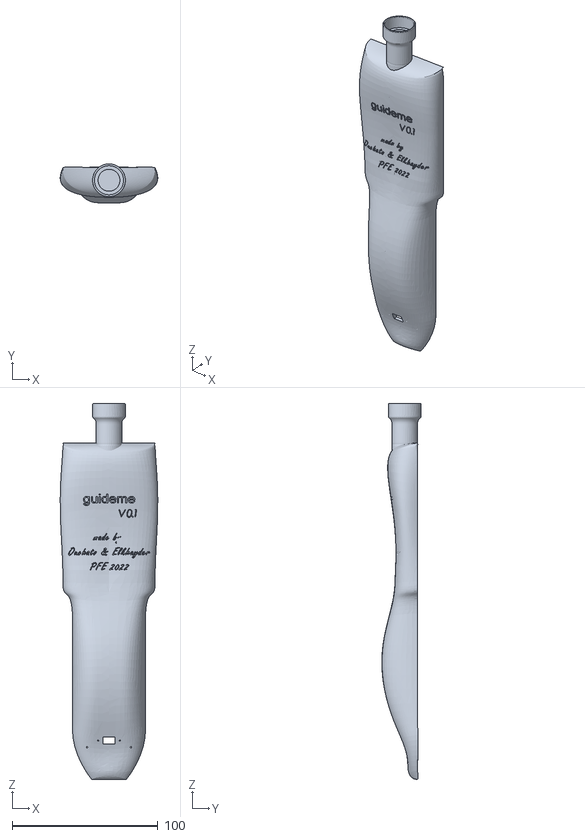
[picture p284: CAD file, 2022-04-11]
sw/lower part v2.STL
66.9 x 27.0 x 257.8
