elkhayder/PFE-DUT-2022-SmartCane/sw/proteus/usb board.STEP

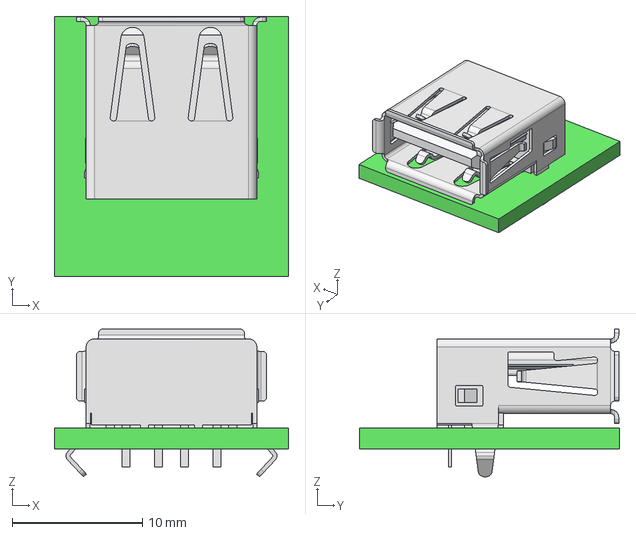
[picture p285: CAD file, 2022-04-20]
sw/proteus/usb board.STEP
18.0 x 20.0 x 11.4 mm
Layer_1
