elkhayder/PFE-DUT-2022-SmartCane/model.SLDPRT

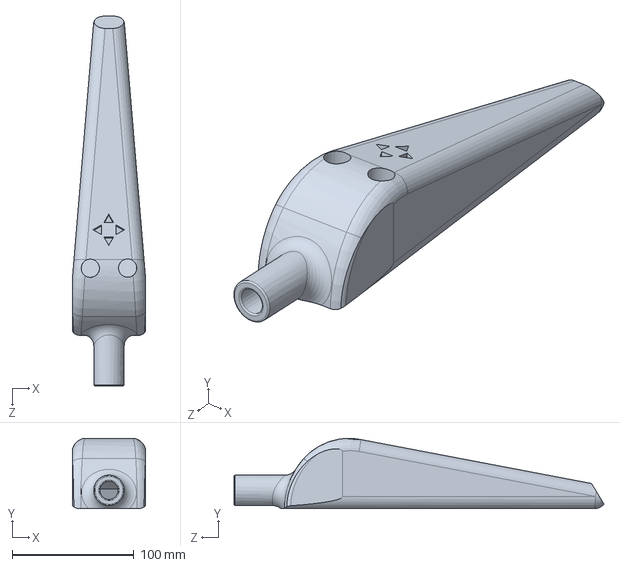
[picture p286: CAD file, 2022-02-23]
model.SLDPRT
60.0 x 57.7 x 303.7 mm
