elkhayder/PFE-DUT-2022-SmartCane/sw/upper part feature 2.STL

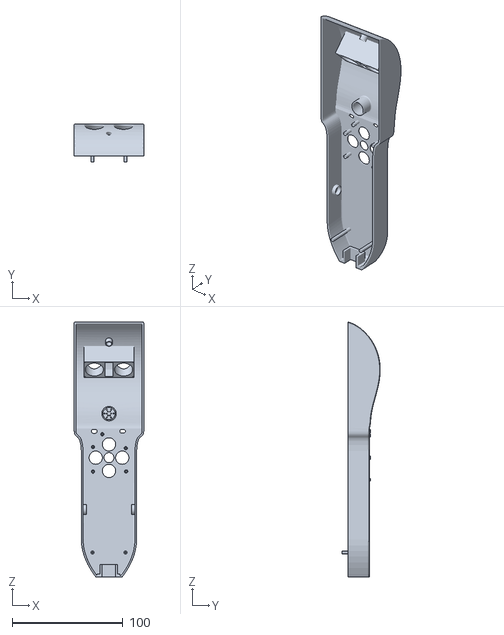
[picture p287: CAD file, 2022-04-11]
sw/upper part feature 2.STL
63.1 x 34.7 x 230.7
