elkhayder/PFE-DUT-2022-SmartCane/sw/slave stick.SLDPRT

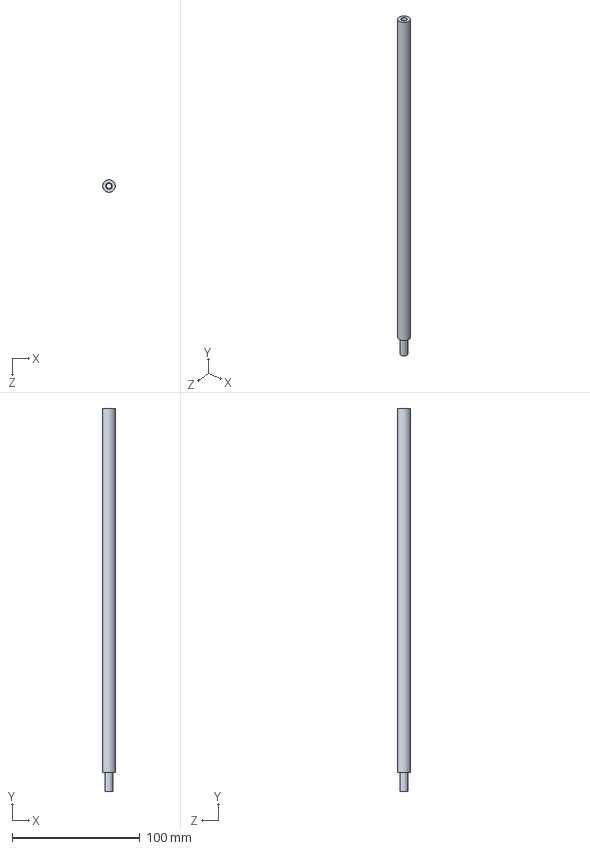
[picture p288: CAD file, 2022-04-11]
sw/slave stick.SLDPRT
10.0 x 300.0 x 10.0 mm
