elkhayder/PFE-DUT-2022-SmartCane/sw/upper part 2.sldprt

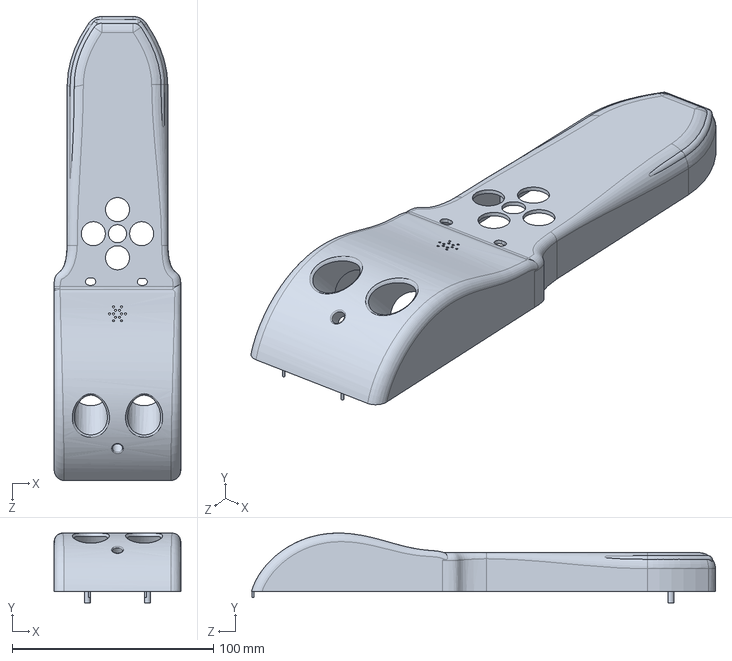
[picture p289: CAD file, 2022-04-11]
sw/upper part 2.sldprt
63.1 x 34.7 x 230.7 mm
