elkhayder/PFE-DUT-2022-SmartCane/sw/upper part.sldprt

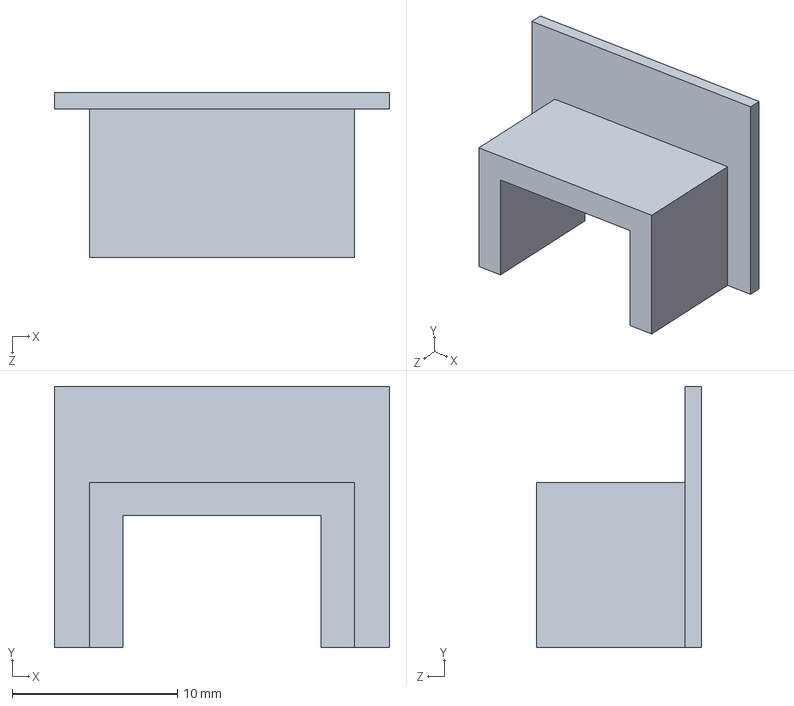
[picture p290: CAD file, 2022-04-11]
sw/upper part.sldprt
20.3 x 15.8 x 10.0 mm
