elkhayder/PFE-DUT-2022-SmartCane/sw/1.SLDPRT

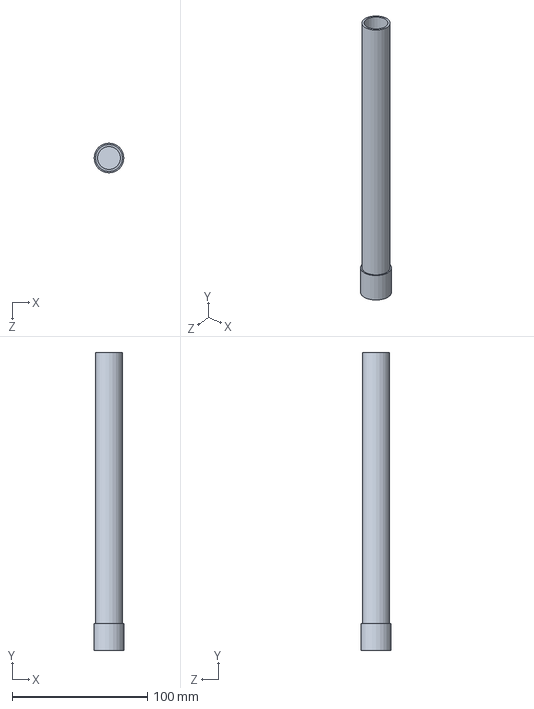
[picture p291: CAD file, 2022-04-11]
sw/1.SLDPRT
22.0 x 220.0 x 22.0 mm
