elkhayder/PFE-DUT-2022-SmartCane/sw/button.SLDPRT

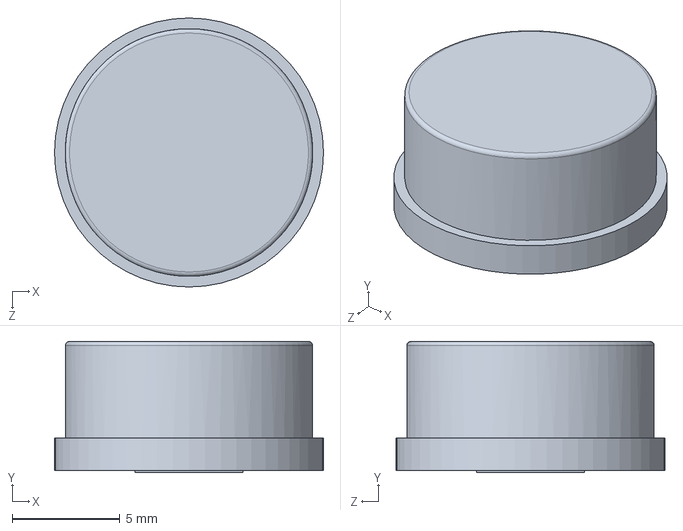
[picture p292: CAD file, 2022-04-11]
sw/button.SLDPRT
12.5 x 6.10 x 12.5 mm
