elkhayder/PFE-DUT-2022-SmartCane/sw/mid cap.SLDPRT

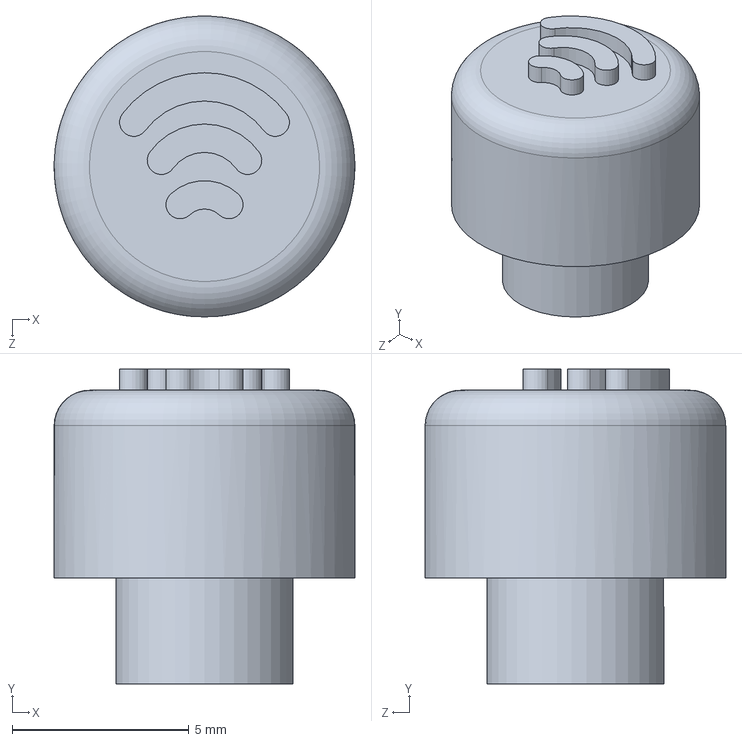
[picture p293: CAD file, 2022-04-11]
sw/mid cap.SLDPRT
8.50 x 8.90 x 8.50 mm
