elkhayder/PFE-DUT-2022-SmartCane/sw/Buttons v2.2.SLDPRT

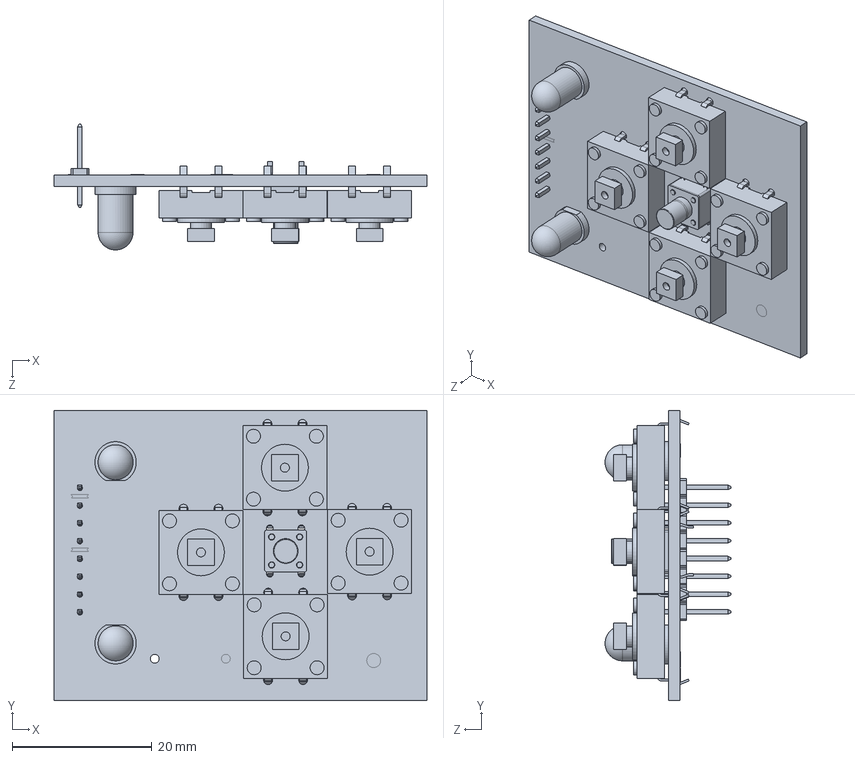
[picture p294: CAD file, 2022-04-11]
sw/Buttons v2.2.SLDPRT
53.3 x 41.5 x 18.0 mm
