elkhayder/PFE-DUT-2022-SmartCane/sw/master stick.SLDPRT

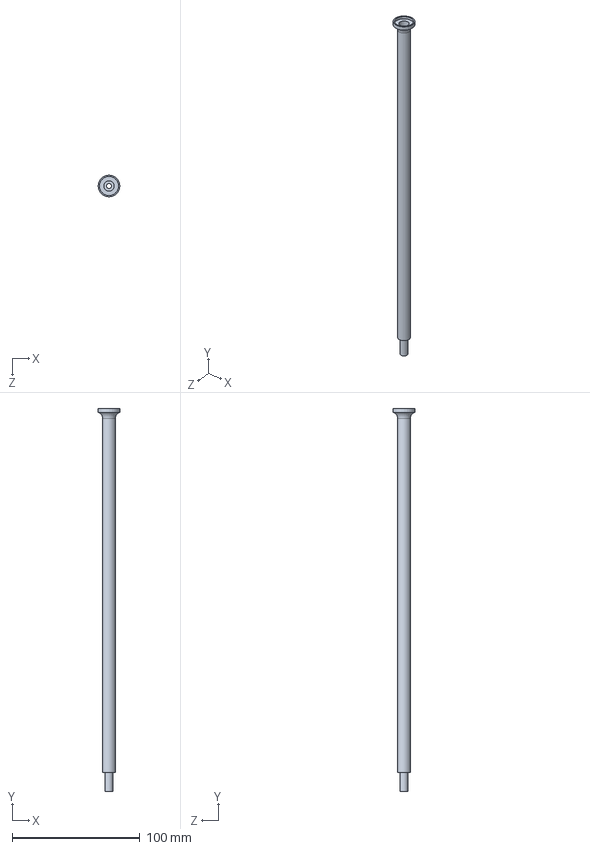
[picture p295: CAD file, 2022-04-11]
sw/master stick.SLDPRT
17.0 x 300.0 x 17.0 mm
