elkhayder/PFE-DUT-2022-SmartCane/sw/flash led.SLDPRT

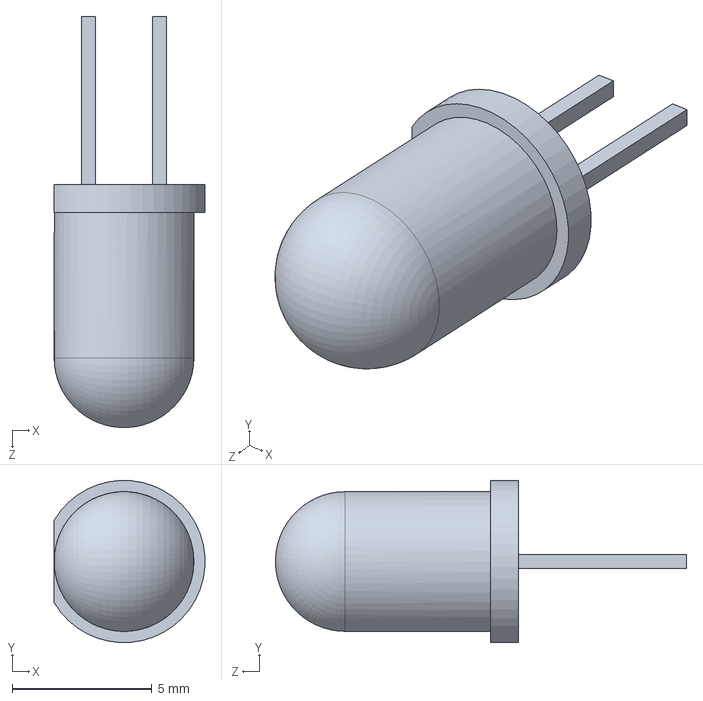
[picture p296: CAD file, 2022-04-11]
sw/flash led.SLDPRT
5.39 x 5.79 x 14.7 mm
