elkhayder/PFE-DUT-2022-SmartCane/sw/tip.SLDPRT

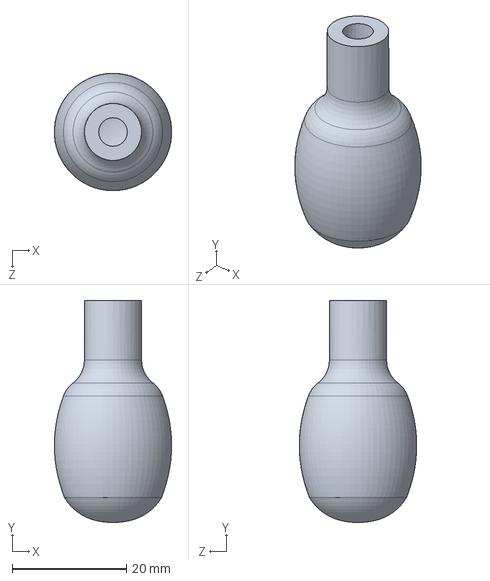
[picture p297: CAD file, 2022-04-11]
sw/tip.SLDPRT
20.5 x 38.8 x 20.5 mm
