elkhayder/PFE-DUT-2022-SmartCane/sw/99.SLDPRT

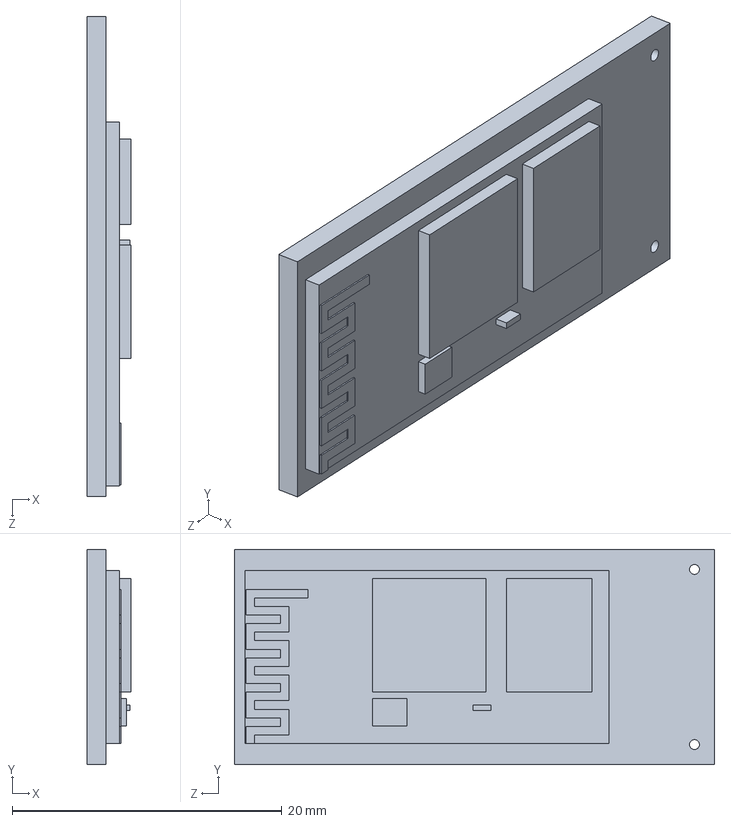
[picture p298: CAD file, 2022-04-05]
sw/99.SLDPRT
3.25 x 16.0 x 35.6 mm
