elkhayder/PFE-DUT-2022-SmartCane/sw/Power Switch.SLDPRT

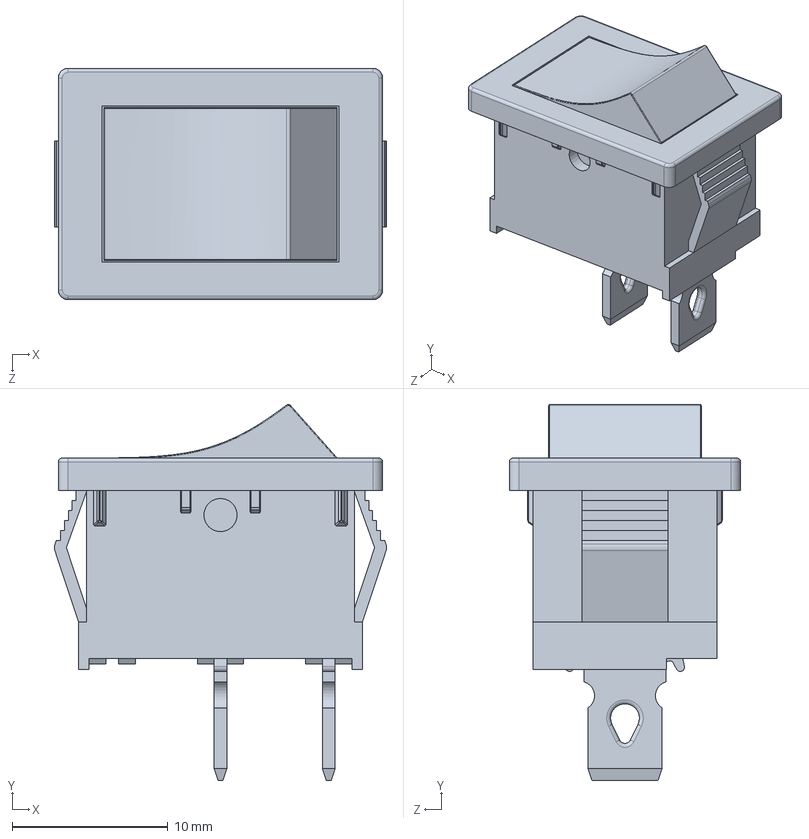
[picture p299: CAD file, 2022-04-05]
sw/Power Switch.SLDPRT
21.3 x 24.1 x 14.9 mm
