elkhayder/PFE-DUT-2022-SmartCane/sw/HC-SR04 with vertical header.SLDPRT

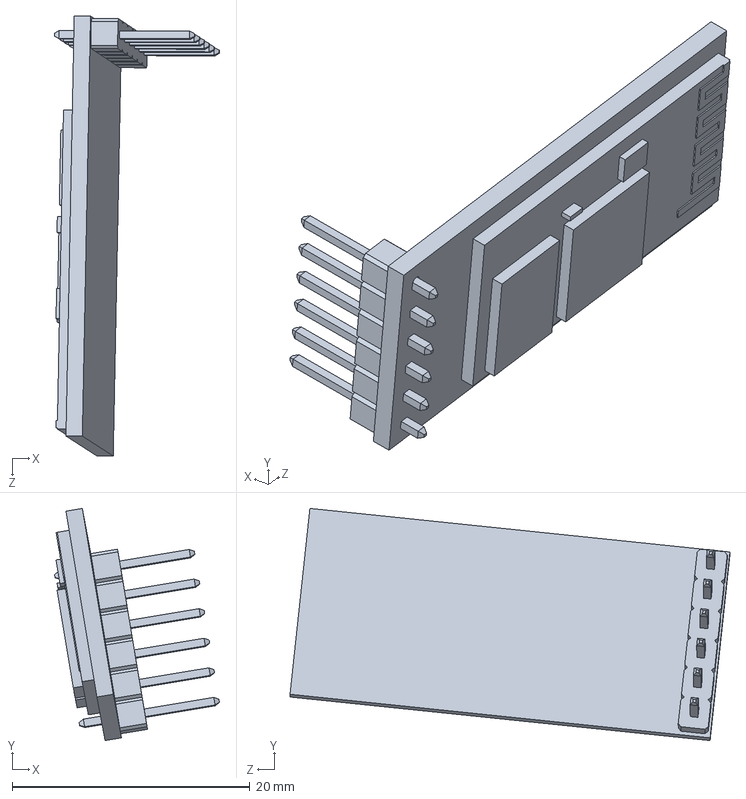
[picture p300: CAD file, 2022-04-05]
sw/HC-SR04 with vertical header.SLDPRT
13.9 x 19.5 x 37.0 mm
