elkhayder/PFE-DUT-2022-SmartCane/sw/sensor socket.SLDPRT

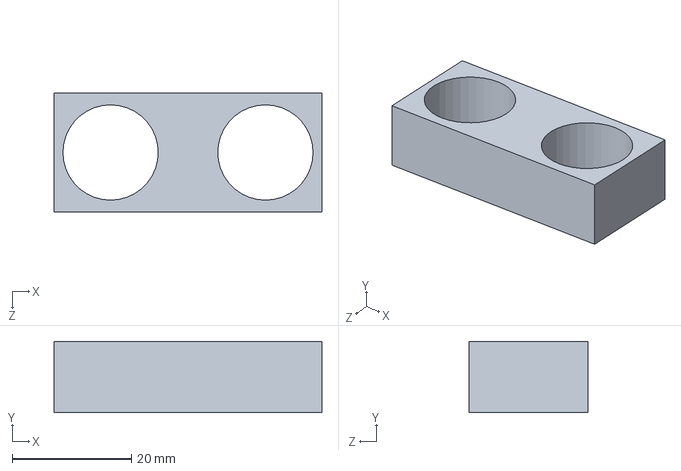
[picture p301: CAD file, 2022-04-05]
sw/sensor socket.SLDPRT
45.0 x 12.0 x 20.0 mm
