elkhayder/PFE-DUT-2022-SmartCane/sw/usb board.SLDPRT

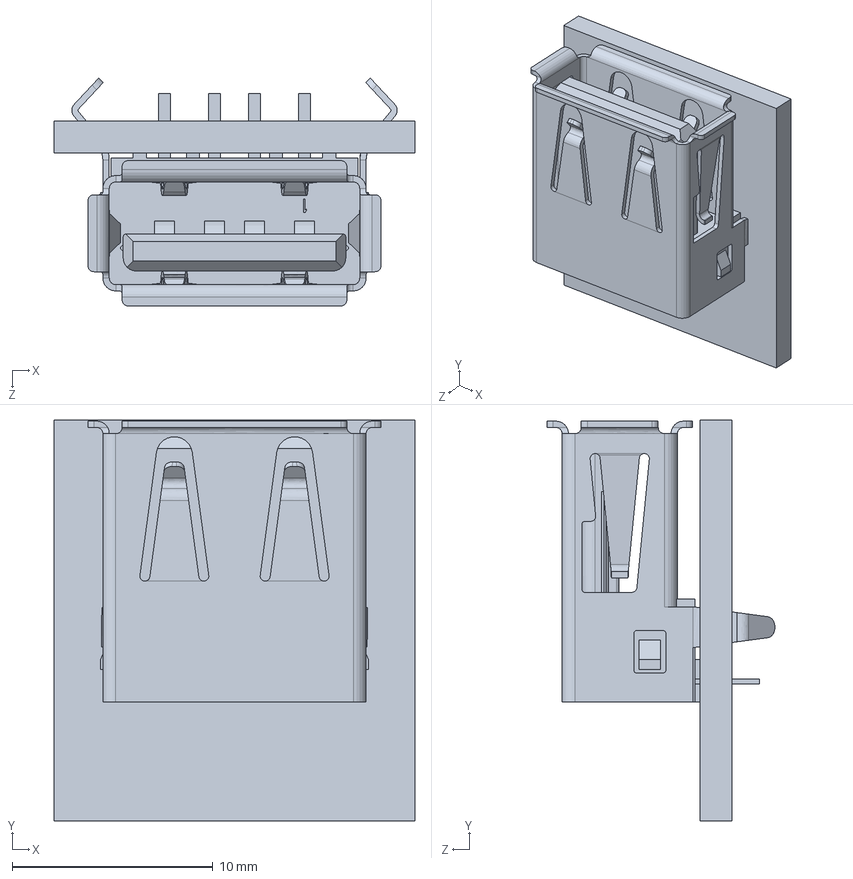
[picture p302: CAD file, 2022-04-05]
sw/usb board.SLDPRT
18.0 x 20.0 x 11.4 mm
