elkhayder/PFE-DUT-2022-SmartCane/sw/Buttons v2.STEP

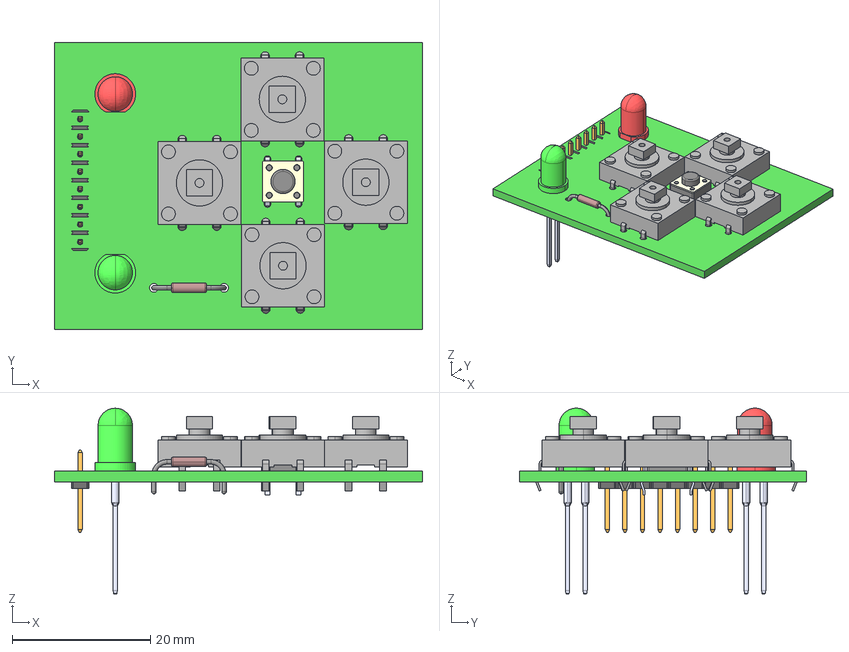
[picture p303: CAD file, 2022-04-05]
sw/Buttons v2.STEP
53.3 x 41.5 x 26.9 mm
Layer_1
=>[0:1:1:3] x 3
=>[0:1:1:4] x 3
=>[0:1:1:5] x 3
=>[0:1:1:6]
=>[0:1:1:7]
=>[0:1:1:8]
=>[0:1:1:9]
=>[0:1:1:10]
=>[0:1:1:11]
=>[0:1:1:12]
=>[0:1:1:13]
8-Pin_Header_-_Male_-_2.54mm:1
Pin_1
Pin_2
