elkhayder/PFE-DUT-2022-SmartCane/sw/lower part v0.2.SLDPRT

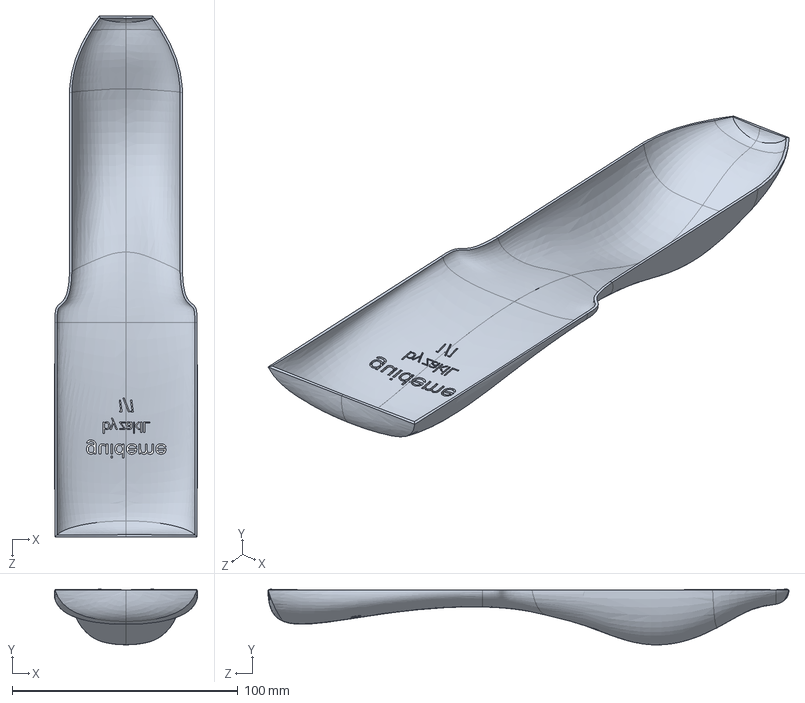
[picture p304: CAD file, 2022-04-05]
sw/lower part v0.2.SLDPRT
63.5 x 24.8 x 230.7 mm
