elkhayder/PFE-DUT-2022-SmartCane/sw/lipo.SLDPRT

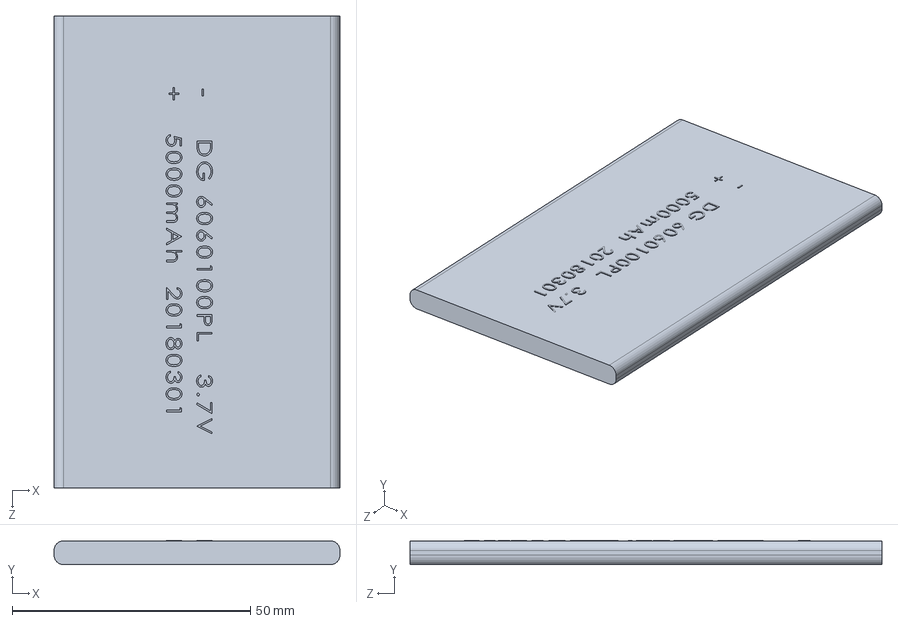
[picture p305: CAD file, 2022-04-05]
sw/lipo.SLDPRT
60.0 x 5.10 x 99.0 mm
