elkhayder/PFE-DUT-2022-SmartCane/sw/printer test.SLDPRT

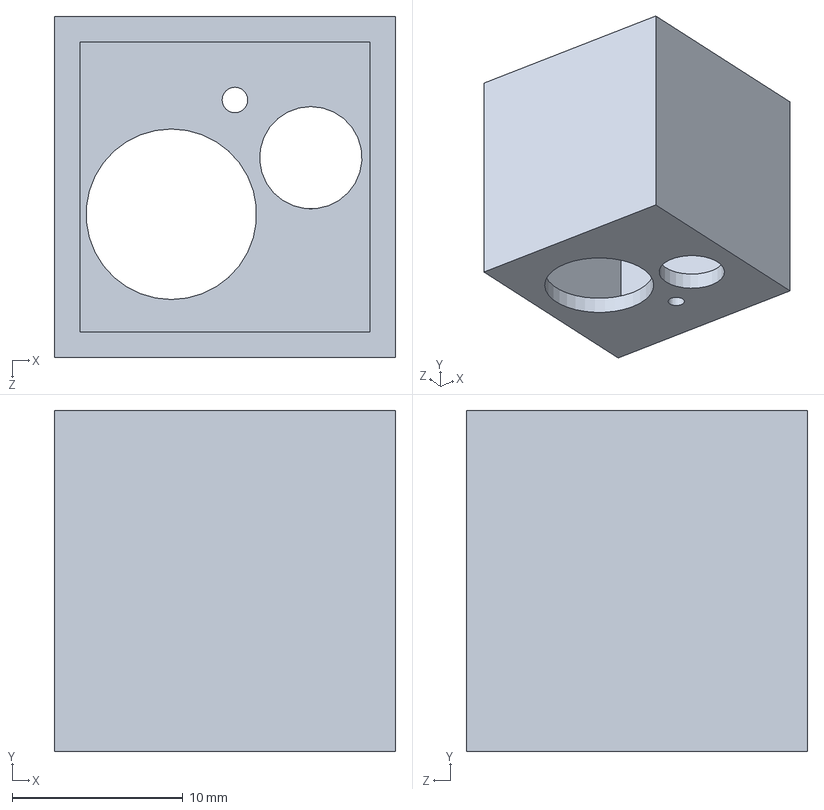
[picture p306: CAD file, 2022-04-03]
sw/printer test.SLDPRT
20.0 x 20.0 x 20.0 mm
