elkhayder/PFE-DUT-2022-SmartCane/sw/HC-05 Bluetooth.SLDPRT

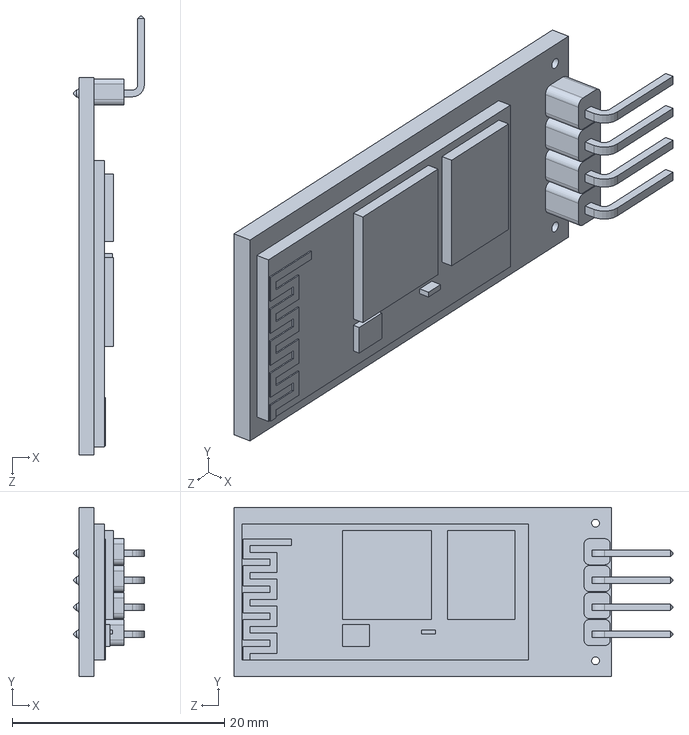
[picture p307: CAD file, 2022-03-25]
sw/HC-05 Bluetooth.SLDPRT
6.68 x 16.0 x 41.4 mm
