elkhayder/PFE-DUT-2022-SmartCane/sw/15-Pin Header - Female - 2.54mm.SLDPRT

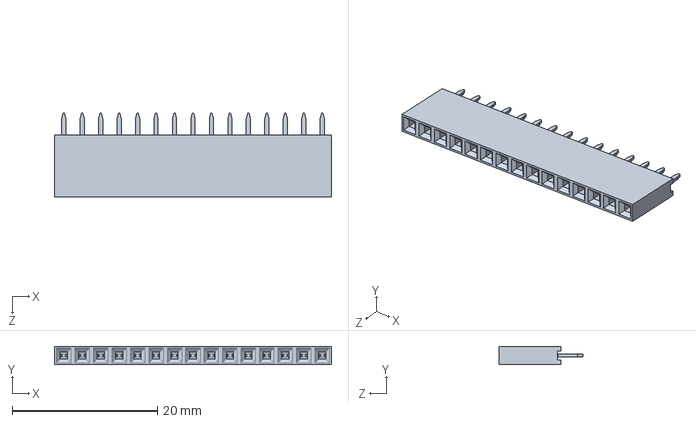
[picture p308: CAD file, 2022-03-25]
sw/15-Pin Header - Female - 2.54mm.SLDPRT
38.1 x 2.54 x 11.5 mm
