elkhayder/PFE-DUT-2022-SmartCane/sw/button pcb.SLDPRT

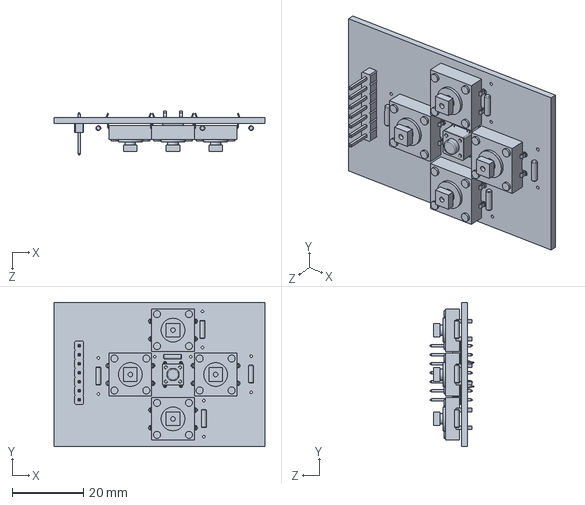
[picture p309: CAD file, 2022-03-25]
sw/button pcb.SLDPRT
59.4 x 40.6 x 12.4 mm
