elkhayder/PFE-DUT-2022-SmartCane/(list of files, cad)

Other CAD files:
sw/upper part feature v2.SLDPRT
sw/upper part feature.STEP
lower part v0.1.SLDPRT
sw/guideme v2.1.SLDASM
sw/guideme v2.SLDASM
sw/lower part v0.1.SLDPRT
sw/lower part v0.2.STL
sw/master stick.STL
sw/mid cap.STL
sw/slave stick.STL
sw/tip.STL
sw/upper part 2.STL
sw/upper part feature.SLDPRT
sw/upper part feature.STL
sw/upper part v0.1.SLDPRT
sw/upper part v0.2.SLDPRT
sw/upper part v1.1.SLDPRT
sw/upper part v1.SLDPRT
