elkhayder/PFE-DUT-2022-SmartCane/sw/proteus/ARDUINO v2.PDF

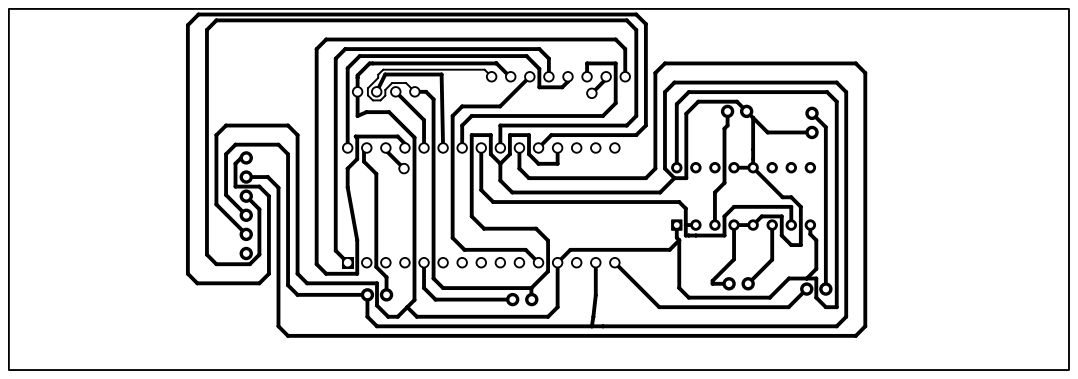
[picture p310: page 1]
