elkhayder/PFE-DUT-2022-SmartCane/sw/proteus/Buttons v2.PDF

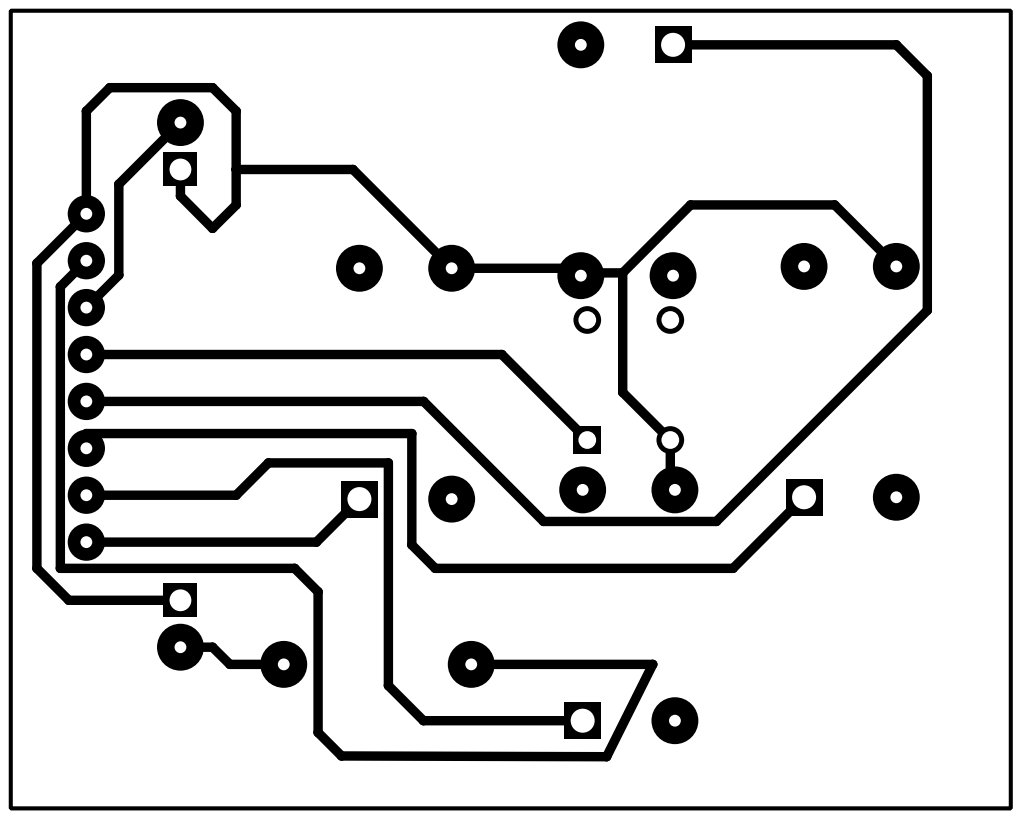
[picture p311: page 1]
