elkhayder/PFE-DUT-2022-SmartCane/(list of files, drawings)

Other design files:
circuit.fzz
sw/proteus/ARDUINO V1.pdsprj
sw/proteus/ARDUINO v2.pdsprj
sw/proteus/Buttons v1.pdsprj
sw/proteus/Buttons v2.pdsprj
sw/proteus/circuit smartcane v1.pdsprj
sw/proteus/Project Backups/ARDUINO v2 [20220325, 17-18-45].pdsprj
sw/proteus/Project Backups/ARDUINO v2 [20220325, 17-18-46].pdsprj
sw/proteus/Project Backups/ARDUINO v2 [20220325, 17-18-48].pdsprj
sw/proteus/Project Backups/ARDUINO v2 [20220325, 18-09-15].pdsprj
sw/proteus/Project Backups/ARDUINO v2 [20220325, 18-25-24].pdsprj
sw/proteus/Project Backups/ARDUINO v2 [20220325, 18-25-25].pdsprj
sw/proteus/Project Backups/Buttons v2 [20220325, 10-55-11].pdsprj
sw/proteus/Project Backups/Buttons v2 [20220325, 11-21-32].pdsprj
sw/proteus/Project Backups/Buttons v2 [20220325, 11-21-33].pdsprj
sw/proteus/Project Backups/Buttons v2 [20220325, 11-25-11].pdsprj
sw/proteus/Project Backups/Buttons v2 [20220325, 16-28-19].pdsprj
sw/proteus/Project Backups/Buttons v2 [20220325, 16-28-21].pdsprj
sw/proteus/Project Backups/Buttons v2 [20220325, 16-40-30].pdsprj
sw/proteus/Project Backups/Buttons v2 [20220325, 17-18-42].pdsprj
sw/proteus/Project Backups/Buttons v2 [20220325, 17-18-43].pdsprj
sw/proteus/Project Backups/Buttons v2 [20220325, 18-25-14].pdsprj
