elkhayder/PFE-DUT-2022-SmartCane/arduino/main/main.ino

#include <Arduino.h>

#include "./services/Bluetooth.cpp"

#include "./handlers/ProximityVibrator.cpp"
#include "./handlers/BatteryReader.cpp"
#include "./handlers/buttons/all.h"

#include "./includes/ringtones.cpp"

void setup()
{
    Serial.begin(9600);

    Bluetooth::setup();

    ProximityVibrator::setup();

    BatteryReader::setup();

    ButtonsAll::setup();

    Ringtones::startup.play();

    delay(1000);
}

void loop()
{
    Bluetooth::loop();

    ProximityVibrator::loop();

    BatteryReader::loop();

    ButtonsAll::loop();
}
