elkhayder/PFE-DUT-2022-SmartCane/arduino/main/handlers/buttons/Left.cpp

#include "../../services/sensors/Button.cpp"

#include "../../services/Bluetooth.cpp"

namespace LeftButton
{
    void onPress()
    {
        String args[] = {"PREVIOUS"};

        Bluetooth::send("NAVIGATABLES", args, 1);
    }

    void onDoublePress()
    {
        Serial.println("Left: Double press");
    }

    void onLongPress()
    {
        Bluetooth::send("SEND_LOCATION_SMS", {}, 0);
    }

    Button button(9, onPress, onDoublePress, onLongPress);

    void setup()
    {
    }

    void loop()
    {
        button.listen();
    }
}
