elkhayder/PFE-DUT-2022-SmartCane/(commit log)

2022-01-27 Added Arduino code, and verified interconnection :fire:
2022-01-27 Reuploaded Arduino folder
2022-02-04 Worked on many stuff, mainly ButtonListener and HC_SR04 on Arduino code
2022-02-04 Fixed ButtonListener port issue :bug:
    [Button.cpp]
2022-02-04 Added onDoublePress to button listener
2022-02-14 More stuff
    [circuit.fzz]
2022-02-15 updated circuit
    [circuit.fzz]
2022-02-22 :bug: Fixed proimity sensor code
    [BatteryReader.cpp, Bluetooth.cpp, HC-SR04.cpp, ProximityVibrator.cpp, main.ino]
2022-03-03 So many stuff I forgot :joy:
    [circuit.fzz]
2022-03-20 Added led to circuit
    [circuit.fzz]
2022-03-22 Added buzzer
    [circuit.fzz]
2022-03-22 Changed Buzzer PIN in code
    [main.ino]
2022-03-23 Changed to speaker
    [circuit.fzz]
2022-03-23 Refactored circuit design :joy:
    [circuit.fzz]
2022-03-26 Seance TP 25/03
    [ARDUINO v2 [20220325, 17-18-45].pdsprj, ARDUINO v2 [20220325, 17-18-46].pdsprj, ARDUINO v2 [20220325, 17-18-48].pdsprj, ARDUINO v2 [20220325, 18-09-15].pdsprj, ARDUINO v2 [20220325, 18-25-24].pdsprj, ARDUINO v2 [20220325, 18-25-25].pdsprj, Buttons v2 [20220325, 10-55-11].pdsprj, Buttons v2 [20220325, 11-21-32].pdsprj]
2022-04-02 Goddam so much stuff I lost track :bug: Mainly finished navigation with cane altough it is hella buggy
    [BatteryReader.cpp, Bot.cpp, Left.cpp, Right.cpp, Top.cpp]
2022-04-08 Created and finished React Website
    [lower part v0.2 l.STL, lower part v0.2.STL, printer test 2.STL, printer test.SLDPRT, printer test.STL]
2022-04-11 solidworks final version parts
    [1.SLDPRT, =_[0_1_1_4]_2.sldprt, =_[0_1_1_4]_3.sldprt, Assem3.SLDASM, Body_1_2.sldasm, Body_1_3.sldasm, Buttons v2.2.SLDPRT, Open CASCADE STEP translator 6.8 1.10.1.sldasm]
2022-04-12 Code finished, still some minor changes to do before release
    [circuit.fzz]
2022-04-20 :yay: finally!
    [15-Pin Header - Female - 2.54mm.SLDPRT, ARDUINO V1.pdsprj, ARDUINO v2 [20220325, 17-18-45].pdsprj, ARDUINO v2 [20220325, 17-18-46].pdsprj, ARDUINO v2 [20220325, 17-18-48].pdsprj, ARDUINO v2 [20220325, 18-09-15].pdsprj, ARDUINO v2 [20220325, 18-25-24].pdsprj, ARDUINO v2 [20220325, 18-25-25].pdsprj]
