elkhayder/PFE-DUT-2022-SmartCane/rapport/assets/realisation/cartes/2022-03-25 12.20.16.jpeg

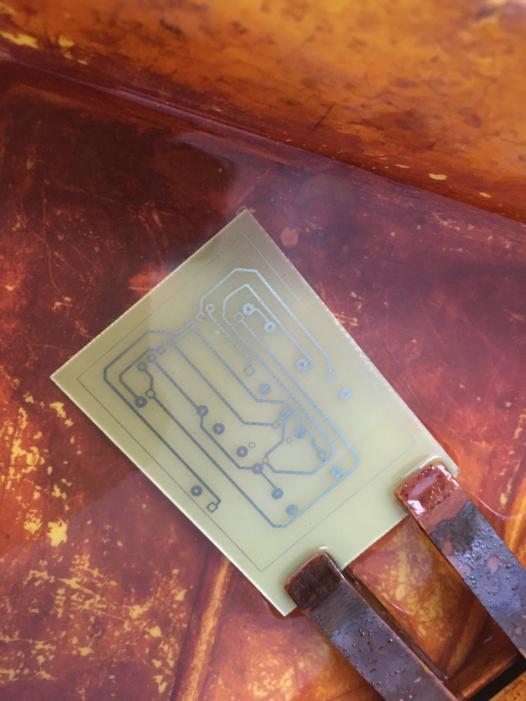
[picture p159: rapport/assets/realisation/cartes/2022-03-25 12.20.16.jpeg]
rapport/assets/realisation/cartes/2022-03-25 12.20.16.jpeg
