elkhayder/PFE-DUT-2022-SmartCane/rapport/assets/realisation/cartes/2022-03-29 14.42.55.jpeg

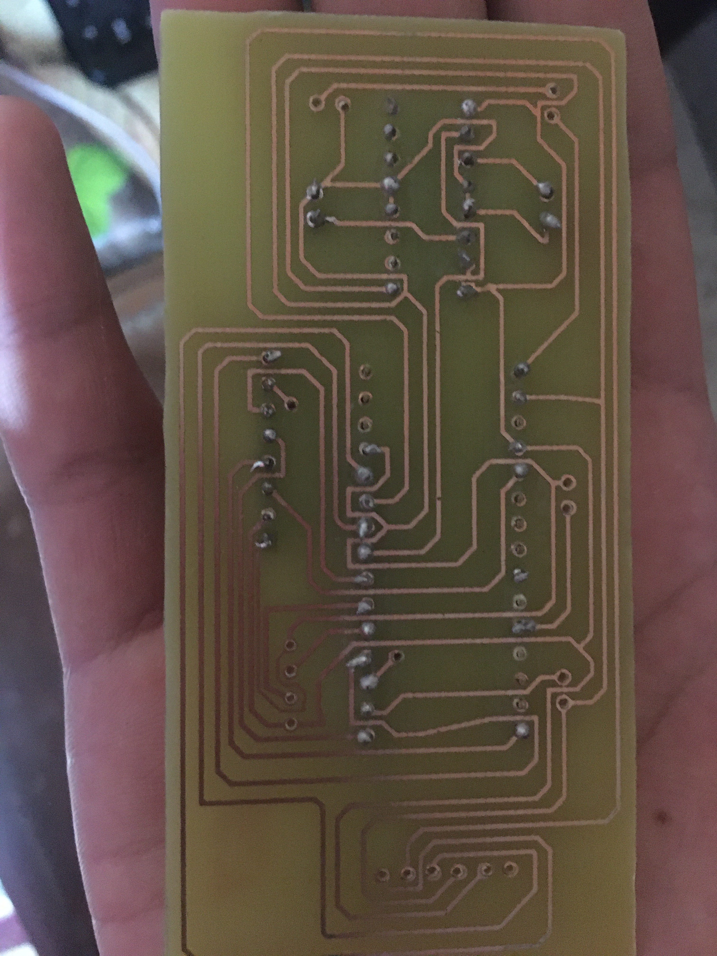
rapport/assets/realisation/cartes/2022-03-29 14.42.55.jpeg
